markopesevski/medyp_1/20180103_proces_autocalibracio.txt

ÉS UN PROCÉS LLARG (~20 min), PACIÈNCIA.
proces per fer autocalibració:
0	connectar el provador a la sortida de RF que tingui connectat el relé més llunyà (Rele3, o connector CN10 a la placa)
1	entrar al menú secret
2	escriure un 0 a la temperatura d'alarma -> set
3	el led del switch hauria de començar a fer intermitències
4	llegir temperatura actual (botó READ)
5	hauria de començar el procés de warm-up durant 2 minuts donant RF a 3 MHz (nivell indeterminat, dependrà de cada placa)
6	després d'aquests 2 minuts de warm-up començarà a buscar els valors d'ajust fi i gruix per cada nivell de tensió donat
7	ESPERAR FINS QUE ACABI I NO TOCAR RES MÉS
8	quan l'aparell hagi apagat la RF (veure amb oscil·loscopi) voldrà dir que ja ha trobat tots els valors
9	donar al botó set de la temperatura d'alarma per sortir del mode de calibració
10	el led del switch hauria de deixar de fer intermitències
11	en aquest punt, sortir del menú secret i comprovar els valors donant RF des del menú normal
12	si els valors estan bé, tornar al menú secret i GUARDAR TODOS LOS VALORES
