markopesevski/medyp_1/20180208_transistors_petats.png

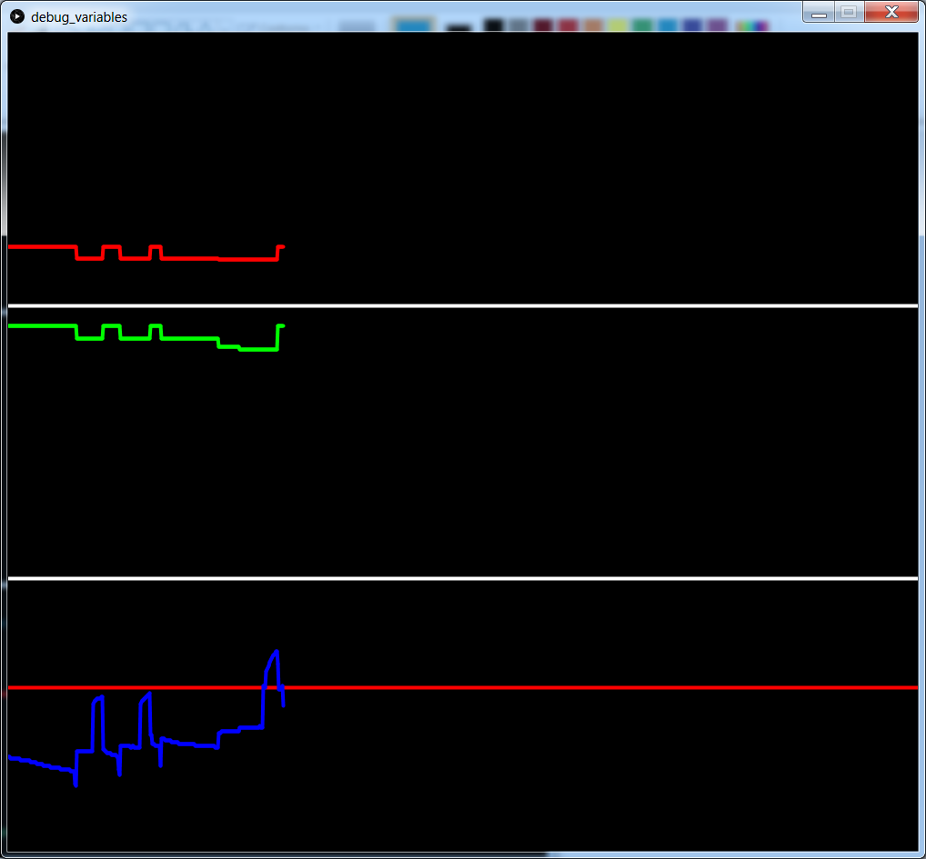
20180208_transistors_petats.png
