markopesevski/medyp_1/20180208_transistors_petats_explicat.png

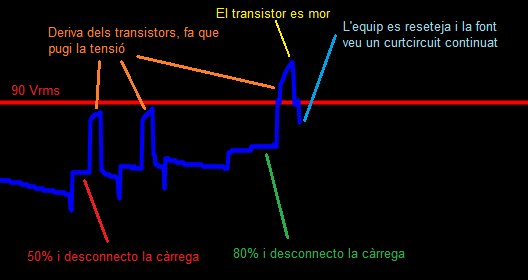
20180208_transistors_petats_explicat.png
