markopesevski/medyp_1/20180209_proves_amb_lluis_garcia.png

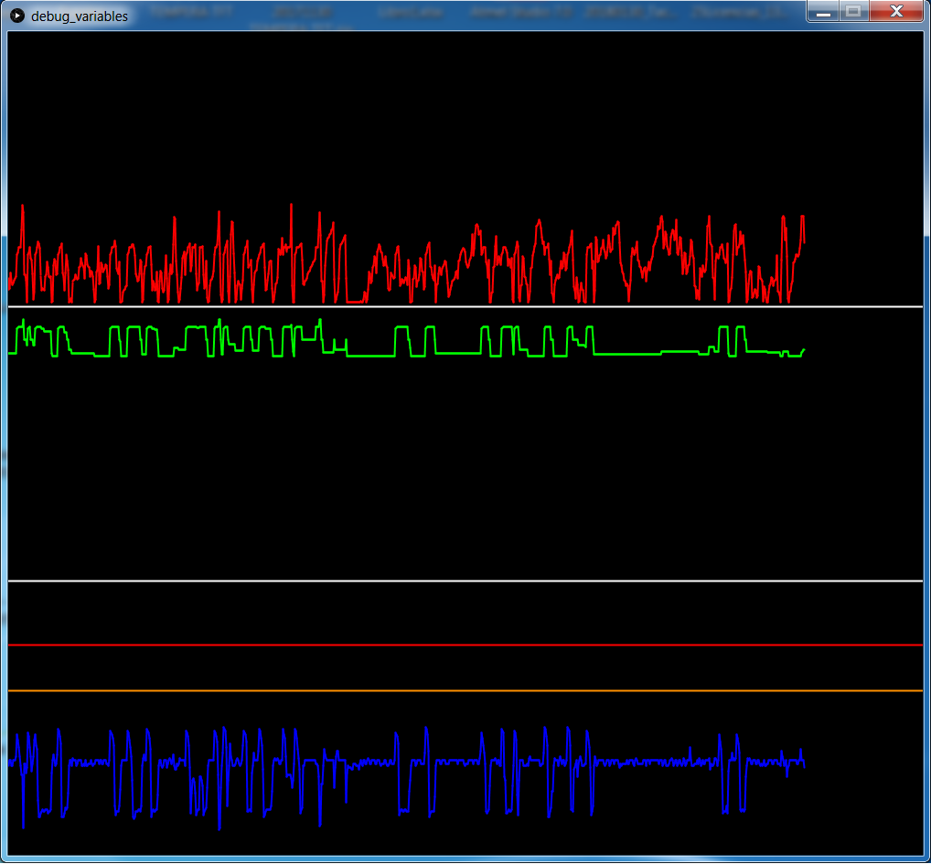
20180209_proves_amb_lluis_garcia.png
