markopesevski/medyp_1/docs/20171207_full control verificacio mesotreat rf_protos_3.xlsx

FULL CONTROL VERIFICACIÓ MESOTREAT
DATA |  | 2017-12-07 |  | Nº SERIE | 3
OPERARI |  | MP |  | VERSIÓ HDW | PROTO
VERSIÓ APK |  | 1 |  | VERSIÓ SFW | 0.1.2
ENCESA INT. OFF a ON |  |  | Ѵ |  | GALV. | 57
LED PULS. |  |  | Ѵ |  | STIM. | 110
PULSADOR |  |  | Ѵ |  | RF | 195
LED RUN |  |  | Ѵ |  | BIAS | 82
LED HUB |  |  | Ѵ |  | AL. TEMP. | 70
TOUCH INICI |  |  | Ѵ | TP9 | 24RF | PROTO Ѵ
STAND BY |  |  | Ѵ | TP13 | 12V | 12,12 Ѵ
APAGAT |  |  | Ѵ | TP11 | 5V IN TAB | 5,03 Ѵ
Fixació USB 1,2,3,4 |  |  | Ѵ | TP4 | 5V | PROTO Ѵ
Lectura Sensr.TEMP |  |  | Ѵ | TP10 | 3,3V | 3,29 Ѵ
 | 100% | 75% | 50% | 25% | 5% | 0%
1MHz -RF CORP. | 85.2 | 83.4 | 81.8 | 79.8 | 74.4 | Ѵ
1MHz -RF FACIAL | 84.9 | 82.9 | 76.8 | 59.8 | 43.3 | Ѵ
1MHz -RF ESPEC. | 84.9 | 82.9 | 76.8 | 59.8 | 43.3 | Ѵ
3MHz -RF CORP. | 75.3 | 69.4 | 62.8 | 53.4 | 41.8 | Ѵ
3MHz -RF FACIAL | 81.1 | 68.4 | 53.8 | 35.8 | 24.7 | Ѵ
3MHz -RF ESPEC. | 81.1 | 68.4 | 53.8 | 35.8 | 24.7 | Ѵ
1-3MHz -RF CORP.CN1 | Ѵ
1-3MHz -RF FACIAL.CN2 | Ѵ
1-3MHz -RF ESPEC.CN3 | Ѵ
G. DETECTA PROBE | Ѵ
GALV.-RF CORP.CN1 | 1.537 | 1.154 | 0.77 | 0.387 | 0.095 | Ѵ
GALV.-RF FACIAL.CN2 | Ѵ
GALV.-RF ESPEC.CN3 | Ѵ
LIFTING GALV. | N/A | N/A | N/A | N/A | N/A | N/A
LIFTING | 61.6 | 47.2 | 30.8 | 14.4 | 1.84 | Ѵ
STIM A CIRCULAT. | 84 | 68.8 | 48 | 24 | 4.8 | Ѵ
STIM B CIRCULAT. | 80 | 70.4 | 48.8 | 24.8 | 4.8 | Ѵ
Senyal DRENANT. | Ѵ
Senyal TENS | Ѵ
Senyal PERCUS. | Ѵ
Senyal REAFIRM. | Ѵ
Senyal PERMEAB. | Ѵ
 |  |  |  | Ѵ | PASS
 |  |  |  |  | FAULT
 |  |  |  | Ѵ | PASS
