markopesevski/medyp_1/20180116_comparativa_autocalibracio_lent_vs_rapid.xlsx

 |  | rapid
 |  | 1 MHz facial |  | 1 MHz corporal |  | 1 MHz especific |  | 3 MHz facial |  | 3 MHz corporal |  | 3 MHz especific |  | barrido facial |  | barrido corporal |  | barrido especific
Index | % | LEVEL | DACDDS | LEVEL | DACDDS | LEVEL | DACDDS | LEVEL | DACDDS | LEVEL | DACDDS | LEVEL | DACDDS | LEVEL | DACDDS | LEVEL | DACDDS | LEVEL | DACDDS
0 | 0.0 | 255 | 255 | 255 | 255 | 255 | 255 | 255 | 255 | 255 | 255 | 255 | 255 | 255 | 255 | 255 | 255 | 255 | 255
1 | 5.0 | 231 | 50 | 219 | 43 | 231 | 50 | 236 | 49 | 231 | 43 | 236 | 49 | 233 | 49 | 225 | 43 | 233 | 49
2 | 10.0 | 230 | 43 | 219 | 43 | 230 | 43 | 234 | 54 | 227 | 43 | 235 | 48 | 232 | 48 | 223 | 43 | 232 | 45
3 | 15.0 | 228 | 45 | 219 | 43 | 228 | 45 | 234 | 48 | 223 | 43 | 233 | 53 | 231 | 46 | 221 | 43 | 230 | 49
4 | 20.0 | 226 | 48 | 219 | 43 | 226 | 49 | 226 | 117 | 220 | 43 | 225 | 127 | 226 | 82 | 219 | 43 | 225 | 88
5 | 25.0 | 224 | 52 | 218 | 43 | 225 | 43 | 233 | 44 | 217 | 43 | 232 | 43 | 228 | 48 | 217 | 43 | 228 | 43
6 | 30.0 | 223 | 46 | 217 | 43 | 224 | 47 | 231 | 43 | 215 | 44 | 231 | 46 | 227 | 44 | 216 | 43 | 227 | 46
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
