markopesevski/medyp_1/docs/20171207_CONTROL_VERIFICACION_MESOTREAT_RF_3.xlsx

CONTROL VERIFICACIÓ MESOTREAT RF
DATA: | 07/12/2017 |  |  |  |  | VERSIÓ APK: |  |  |  | 1
EQUIP Nº | PROTO 003 |  | PCB Nº S/N |  | 3 | VERSIÓ PLACA: |  |  |  | 0,1,2
 | 100% (Vpp-rms) |  |  | 75% (Vpp-rms) |  |  | 50% (Vpp-rms) |  |  | 25% (Vpp-rms) |  |  | 5% (Vpp-rms) |  |  | 0% és 0?
 | Min | Mesura | Max | Min | Mesura | Max | Min | Mesura | Max | Min | Mesura | Max | Min | Mesura | Max
RF CORPORAL 1Mhz | 85,1 |  | 85,6 | 83,5 |  | 84 | 83 |  | 83,4 | 79 |  | 80
RF FACIAL 1Mhz | 84,8 |  | 85,2 | 82,9 |  | 83,2 | 77 |  | 77,5 | 62,1 |  | 63
RF CONTORNO 1Mhz | 84,8 |  | 85,2 | 82,9 |  | 83,2 | 77 |  | 77,5 | 62,1 |  | 63
RF CORPORAL 3Mhz | 76,1 |  | 77,3 | 70,6 |  | 71,2 | 63,8 |  | 64,3 | 54 |  | 55,4
RF FACIAL 3Mhz | 74,8 |  | 75,2 | 67,8 |  | 68,3 | 52,8 |  | 54,2 | 34,5 |  | 35,2
RF CONTORNO 3Mhz | 74,8 |  | 75,2 | 67,8 |  | 68,3 | 52,8 |  | 54,2 | 34,5 |  | 35,2
RF CORPORAL 1Mhz - 3Mhz
RF FACIAL 1Mhz - 3Mhz
RF CONTORNO 1Mhz - 3Mhz
 | 100% (mA) |  |  | 75% (mA) |  |  | 50% (mA) |  |  | 25% (mA) |  |  | 5% (mA)
 | Min | Mesura | Max | Min | Mesura | Max | Min | Mesura | Max | Min | Mesura | Max | Min | Mesura | Max
GALVA. CORPORAL
GALVA. FACIAL
GALVA.CONTORNO
 | 100% (Vpp) |  |  | 75% (Vpp) |  |  | 50% (Vpp) |  |  | 25% (Vpp) |  |  | 5% (Vpp)
 | Min | Mesura | Max | Min | Mesura | Max | Min | Mesura | Max | Min | Mesura | Max | Min | Mesura | Max
ELECTROLIFTING
 | 100% (Vp) |  |  | 75% (Vp) |  |  | 50% (Vp) |  |  | 25% (Vp) |  |  | 5% (Vp)
 | Min | Mesura | Max | Min | Mesura | Max | Min | Mesura | Max | Min | Mesura | Max | Min | Mesura | Max
ESTIM A CIRCULATORIA
ESTIM A DRENANTE
ESTIM A TENS
ESTIM A PERCUSION
ESTIM A REAFIRMANTE
ESTIM A PERMEABILIZANTE
ESTIM A CIRCULATORIA
ESTIM A DRENANTE
ESTIM A TENS
ESTIM A PERCUSION
ESTIM A REAFIRMANTE
ESTIM A PERMEABILIZANTE
 |  |  |  | VALORS DAC
ENCESA | OK |  |  | GALVA
CARREGA SOFT APP | OK |  |  | ESTIM
CARREGA SOFT PCB |  |  |  | RF
 |  |  |  | BIAS
 |  |  |  | ALARMA Tº
