markopesevski/medyp_1/sch/mesotreat.pdf

A

B

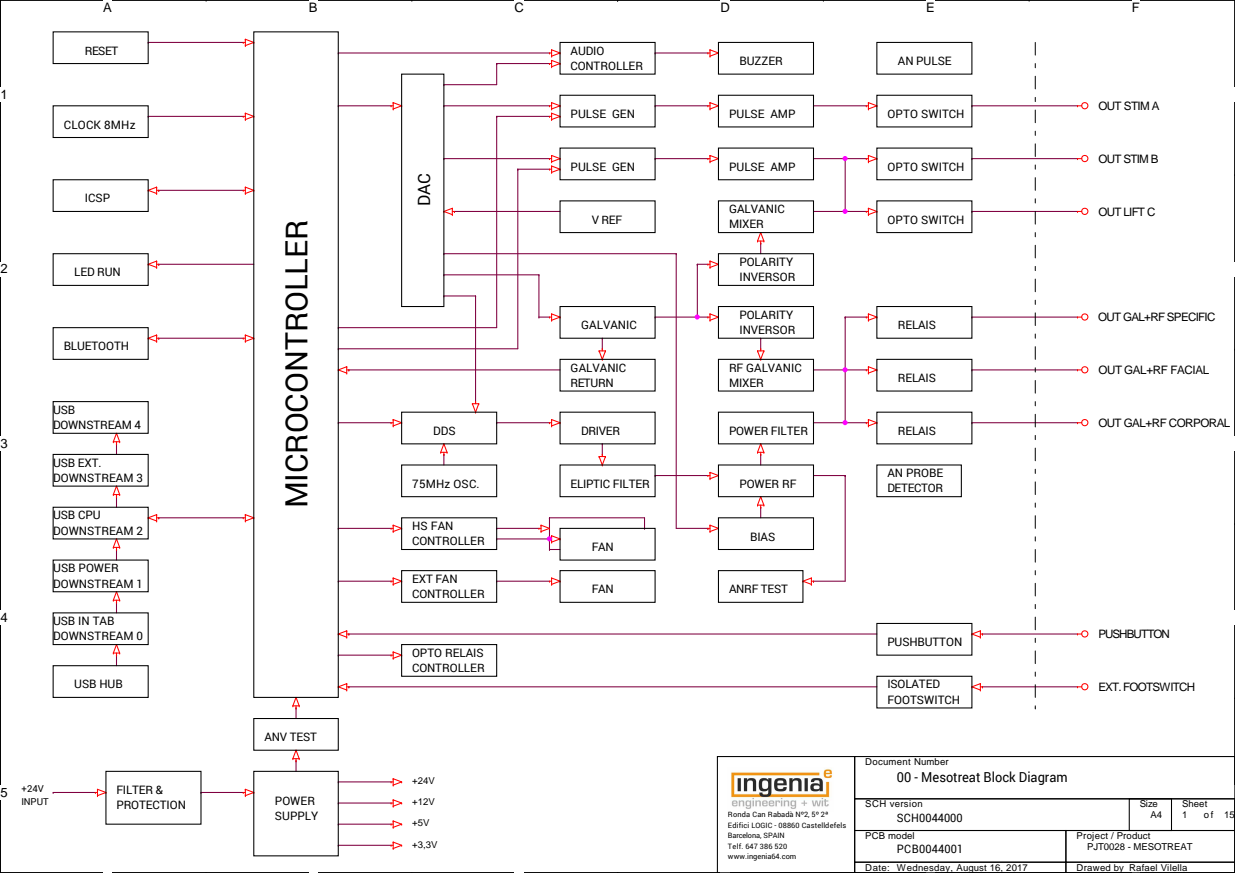
[picture p4: page 1]
EXT. FOOTSWITCH; OUT STIM A; OUT STIM B; OUT LIFT C; PUSHBUTTON; SCH version; Size; Date:; Drawed by; Sheet o f; PCB model; Project / Product; SCH0044000; PCB0044001; Wednesday, August 16, 2017; Rafael Vilella; PJT0028 - MESOTREAT; MICROCONTROLLER; DAC; CLOCK 8MHz; ISOLATED FOOTSWITCH; ICSP; LED RUN; USB HUB; RESET; FILTER & PROTECTION; INPUT; POWER; SUPPLY; DDS; DRIVER; POWER FILTER; GALVANIC RETURN; RELAIS; RF GALVANIC MIXER; POLARITY INVERSOR GALVANIC; POLARITY INVERSOR; OPTO SWITCH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

OUT GAL+RF SPECIFIC

OUT GAL+RF FACIAL

OUT GAL+RF CORPORAL

USB IN TAB
DOWNSTREAM 0

Document Number
00 - Mesotreat Block Diagram

Ronda Can Rabadà Nº2, 5º 2ª
Edifici LOGIC - 08860 Castelldefels
Barcelona, SPAIN
Telf. 647 386 520
www.ingenia64.com

A

B

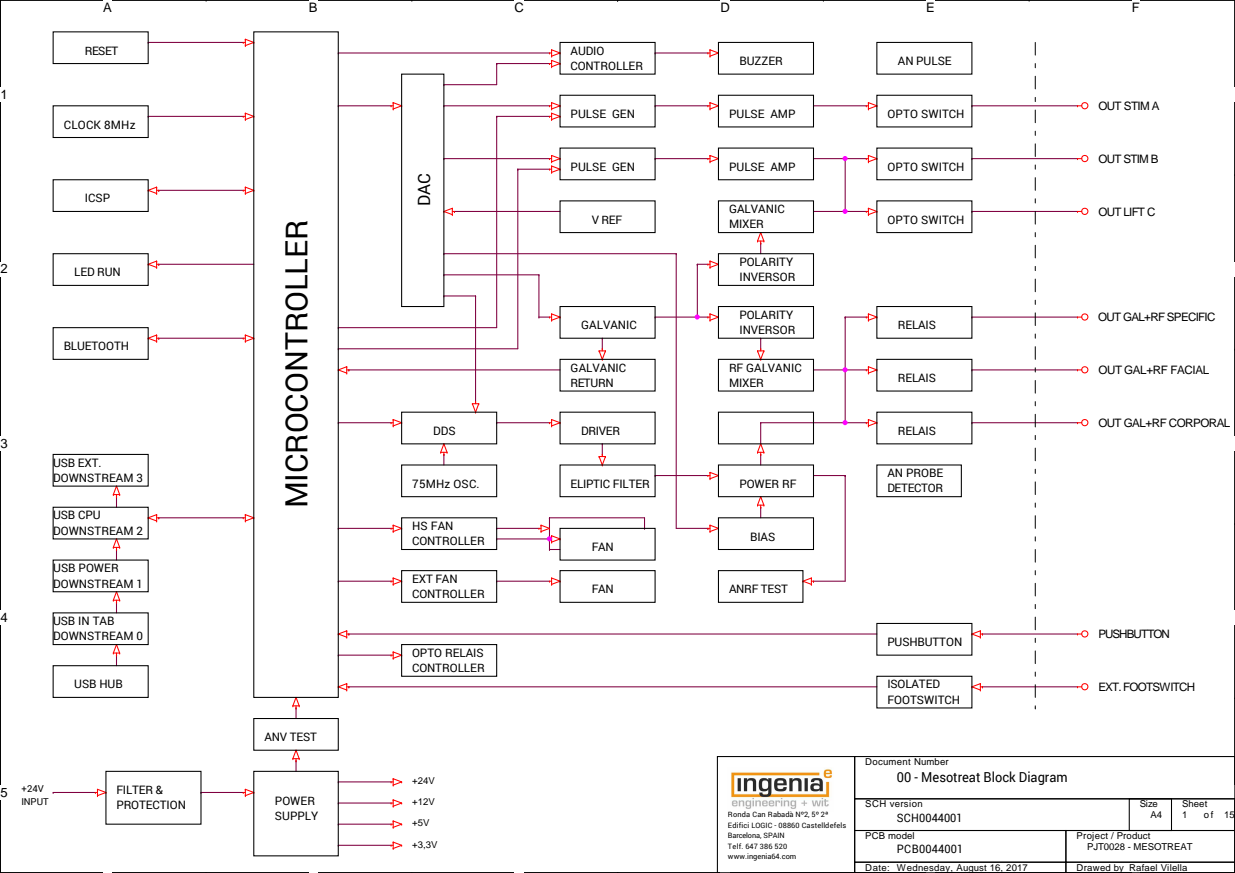
[picture p5: page 2]
EXT. FOOTSWITCH; OUT STIM A; OUT STIM B; OUT LIFT C; PUSHBUTTON; SCH0044001; MICROCONTROLLER; DAC; CLOCK 8MHz; ISOLATED FOOTSWITCH; ICSP; LED RUN; USB HUB; RESET; FILTER & PROTECTION; INPUT; POWER; SUPPLY; DDS; DRIVER; GALVANIC RETURN; RELAIS; RF GALVANIC MIXER; POLARITY INVERSOR GALVANIC; POLARITY INVERSOR; OPTO SWITCH; PULSE AMP; GALVANIC MIXER V REF; 75MHz OSC.; ELIPTIC FILTER; POWER RF; PULSE GEN; BLUETOOTH; BUZZER; AUDIO CONTROLLER; USB EXT. DOWNSTREAM 3; USB CPU DOWNSTREAM 2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

OUT GAL+RF SPECIFIC

OUT GAL+RF FACIAL

OUT GAL+RF CORPORAL

USB IN TAB
DOWNSTREAM 0

Document Number
00 - Mesotreat Block Diagram

D | D
C | C
B | B
A | A

Document Number

### 01 - Miscellanea

A4 | 1 | 15

TORNILLERIA RADIADORS TIP120 SCH 04

PCB0044000 4 LAYERS

TORNILLERIA RADIADOR
7812 SCH 09

TORNILLERIA RADIADOR IRF640x2 LM2596 QFP17P10 LM35 SCH 2 i SCH 10

TORNILLERIA i VENTILADOR

SCWx = SCREW

APx = ARANDELA PLANA

ADIx = ARANDELA DENTADA INTERIOR

NUTx = FAMELLA

ISOx = CLIP PADA 7705

HSPx = HEATSINK PAD

ISO2
M3

SCW6
M3x10

SCW10
M-3,5x35

HSP4
M3

PCB1

PCB0044000

ISO1
M3

FAN1
40x40x20-24V

ISO3
M3

SCW8
M3x10

HSP3
M3

ISO15
M3

NUT5
M3

AP5
M3

ADI5
M3

HSP5
M3

HSP1
M3

SCW5
M3x10

SCW9
M3x10

SCW7
M3x10

HSP2
M3

ISO4
M3

D | D

### Iout=??ADC

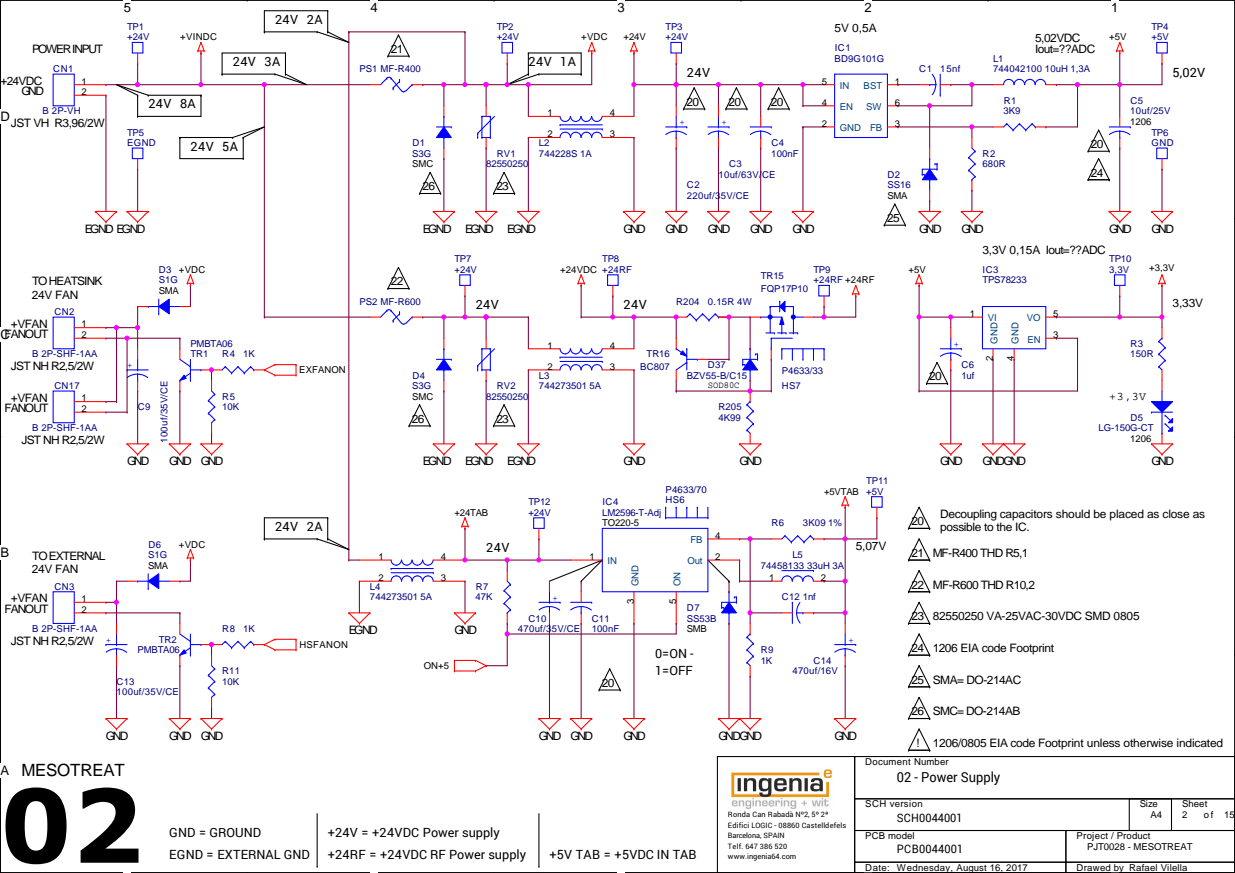
[picture p6: page 4]

Decoupling capacitors should be placed as close as
possible to the IC. 20

! 1206/0805 EIA code Footprint unless otherwise indicated

D | D

### GND

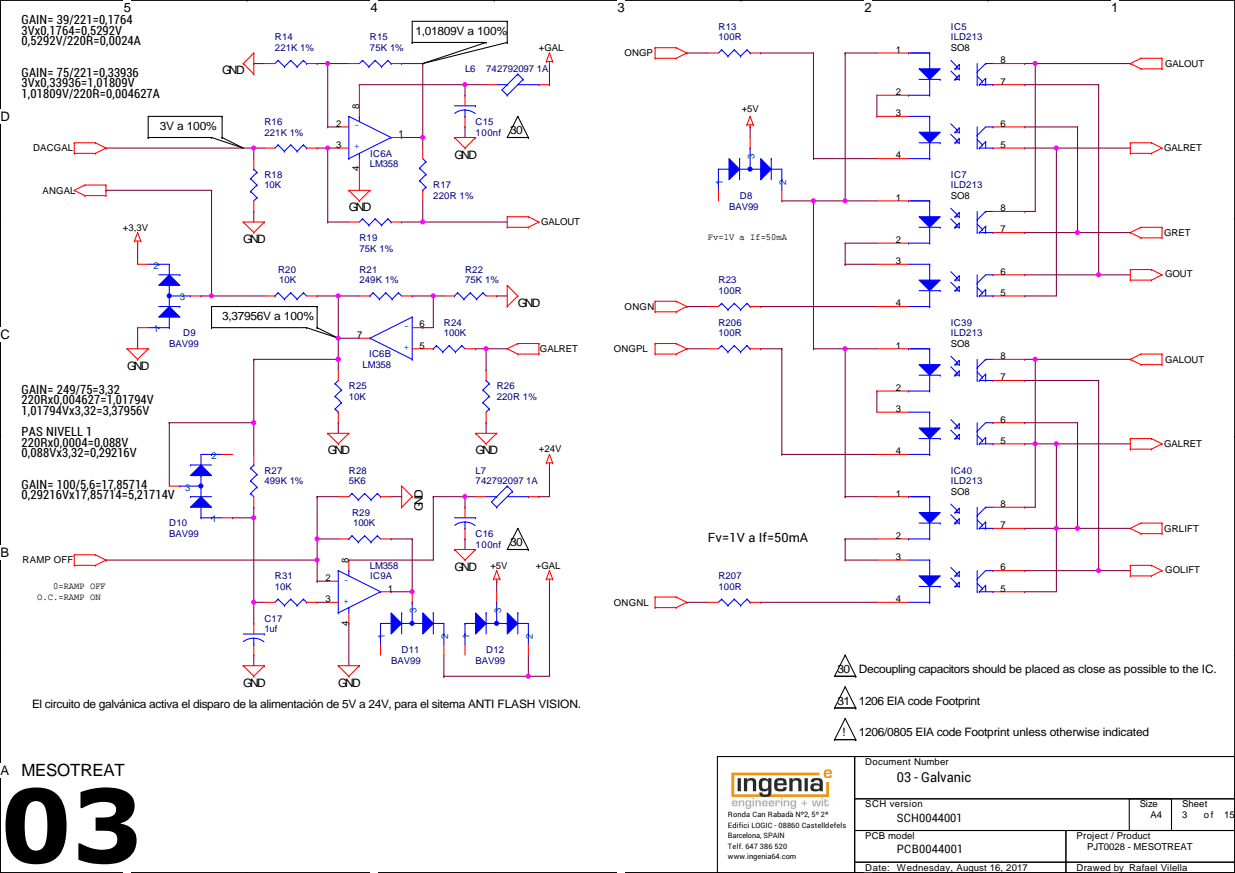
[picture p7: page 5]

30 Decoupling capacitors should be placed as close as possible to the IC.

El circuito de galvánica activa el disparo de la alimentación de 5V a 24V, para el sitema ANTI FLASH VISION.

! 1206/0805 EIA code Footprint unless otherwise indicated

D | D

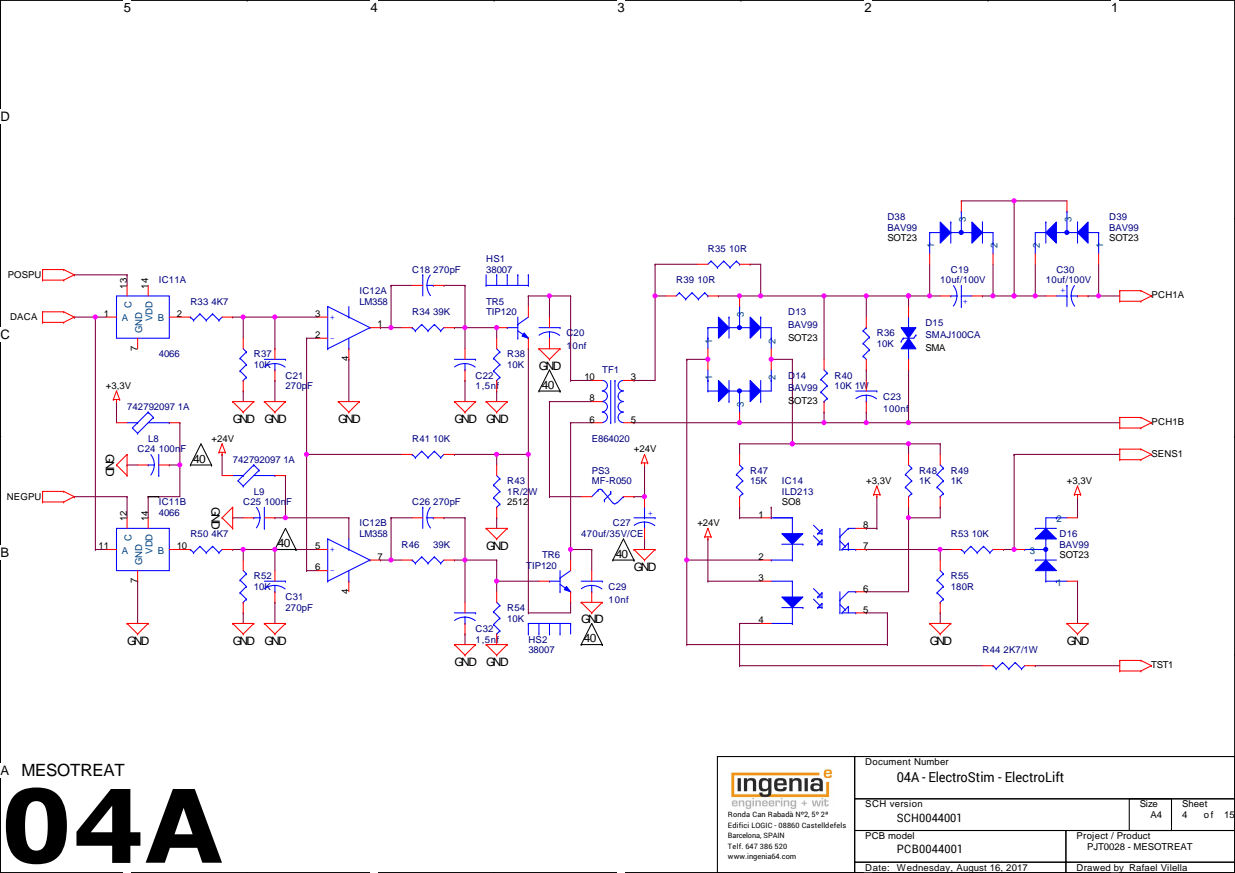
[picture p8: page 6]

D | D

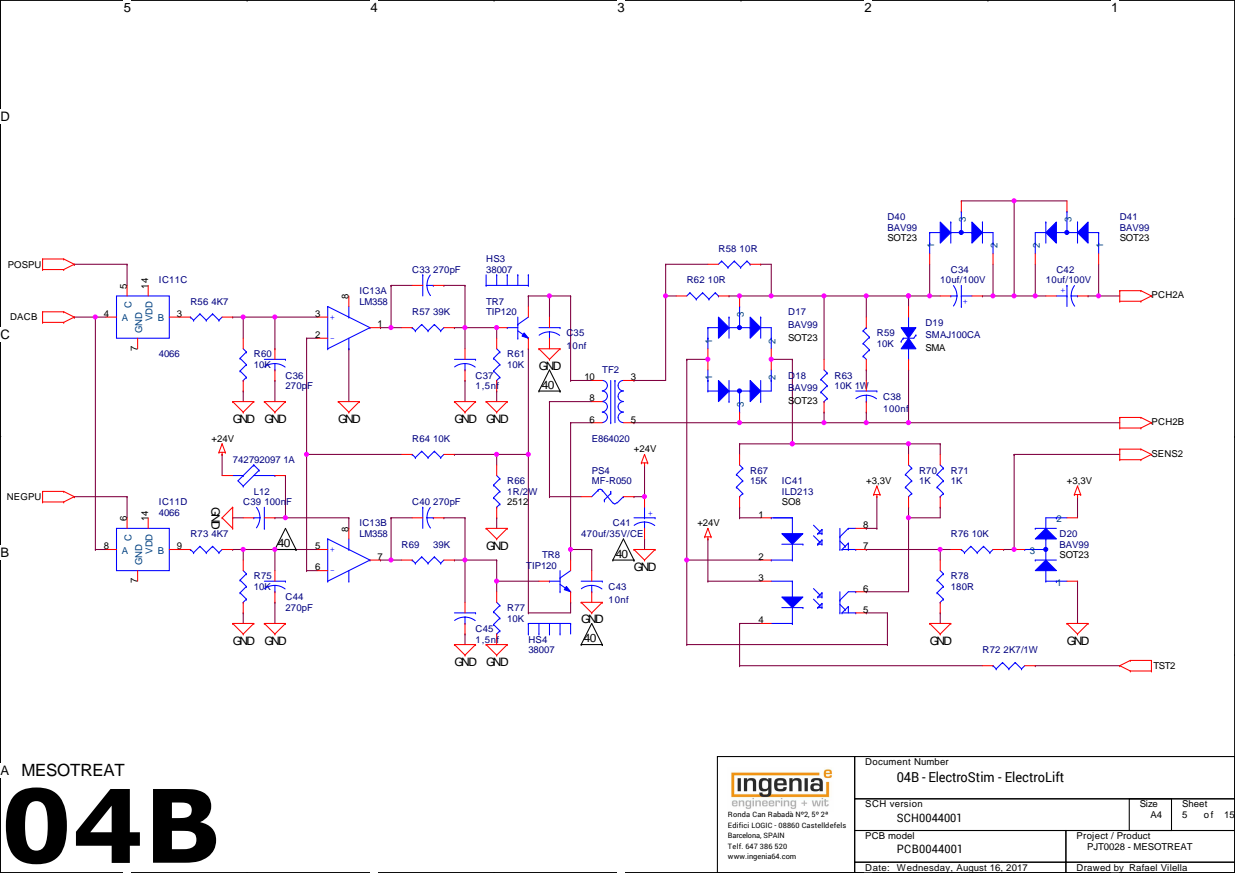
[picture p9: page 7]

D | D
GND | GND

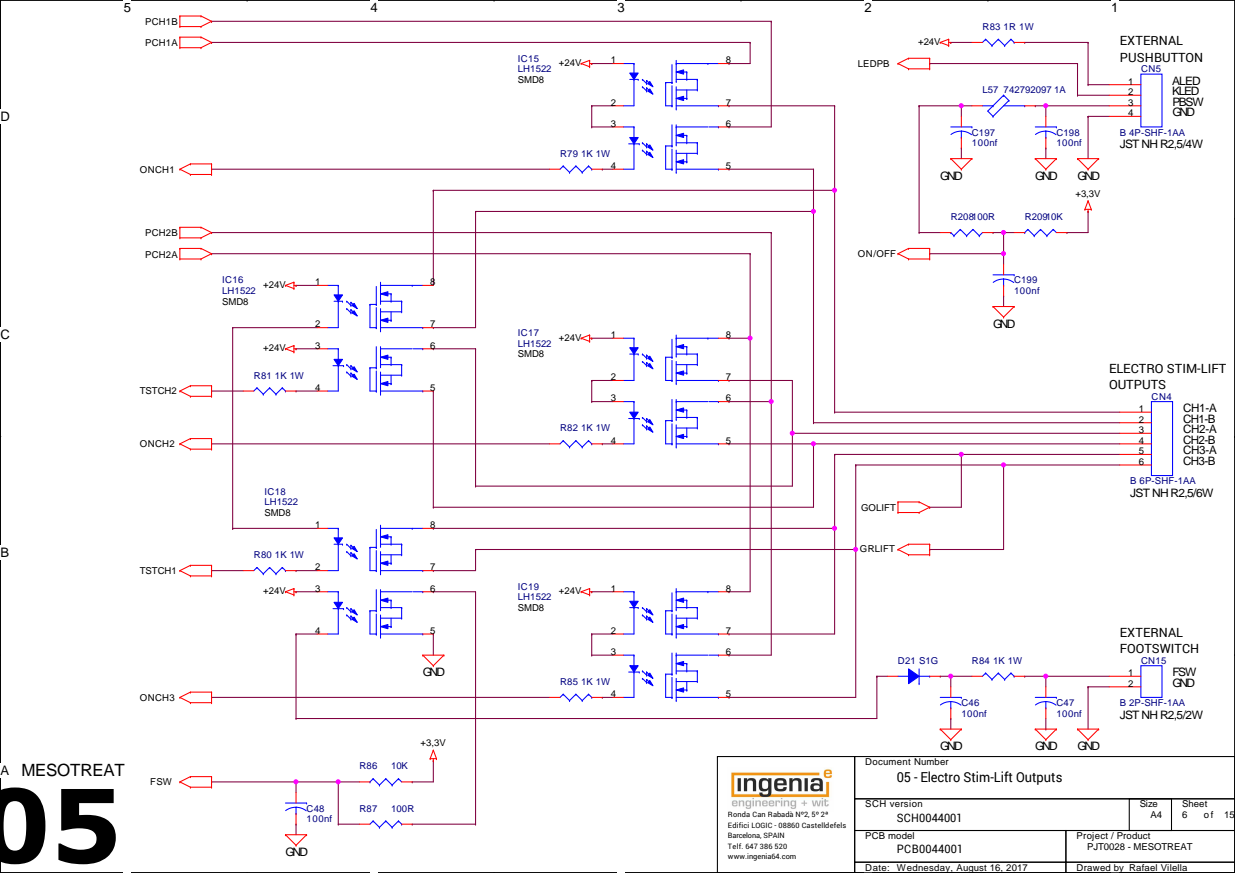
[picture p10: page 8]

Document Number
05 - Electro Stim-Lift Outputs

D | D

61

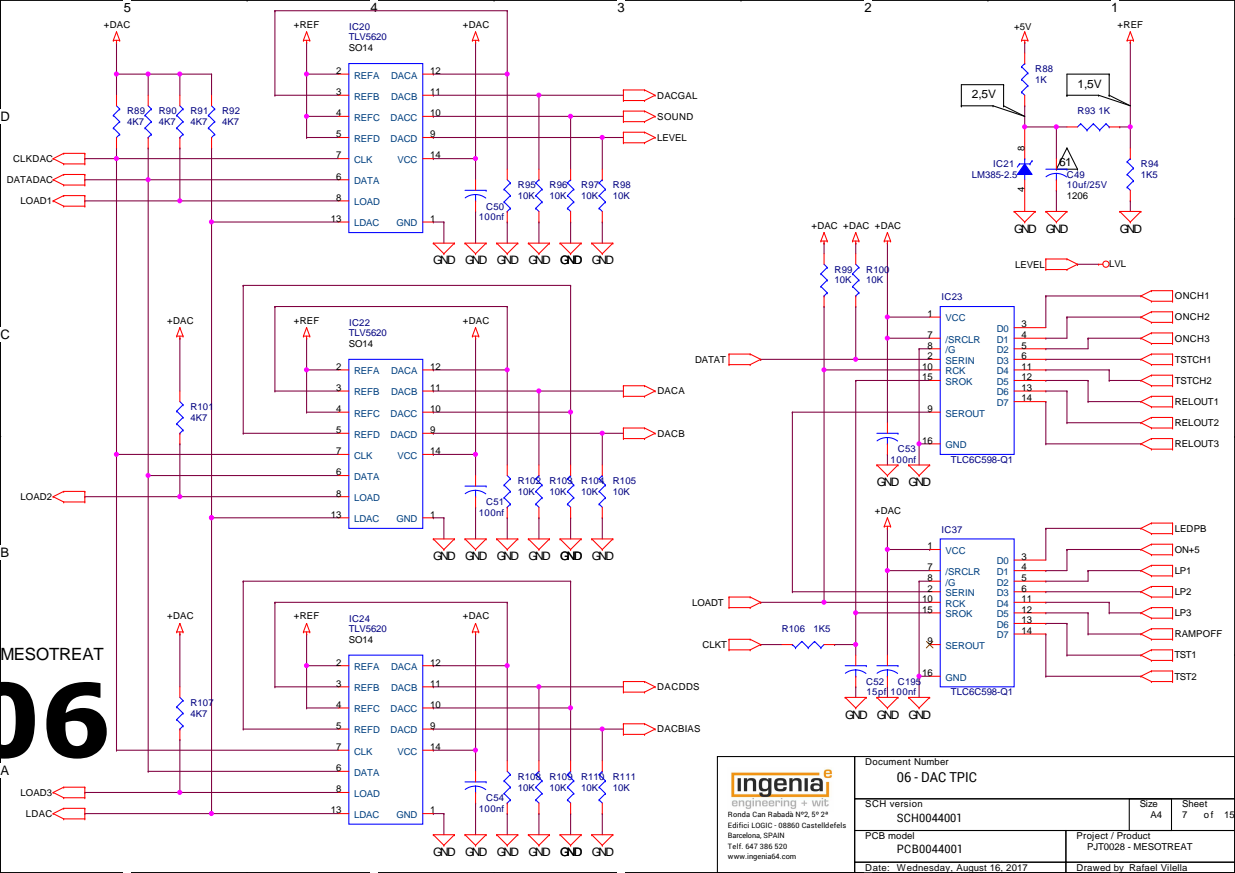
[picture p11: page 9]

D | D

### GND

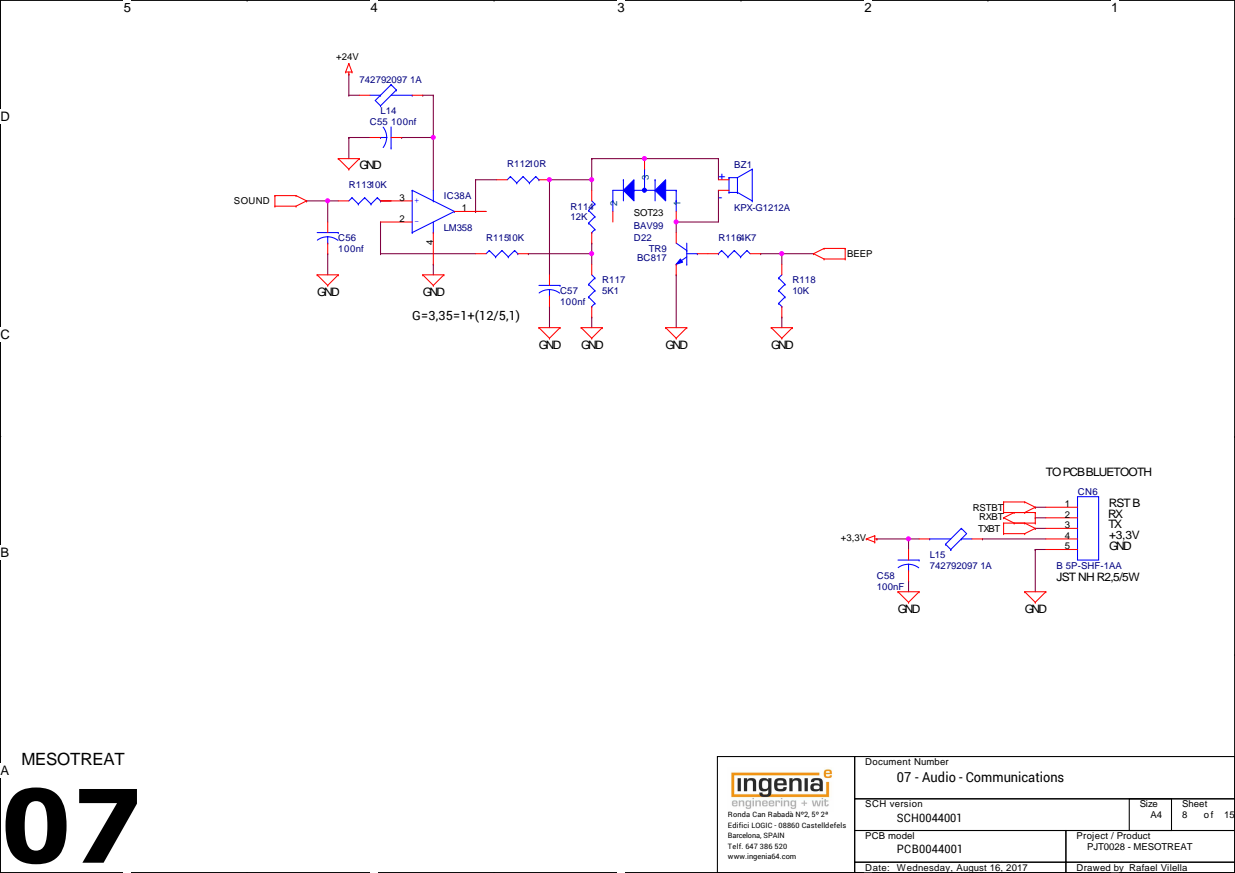
[picture p12: page 10]

D | D

### GND

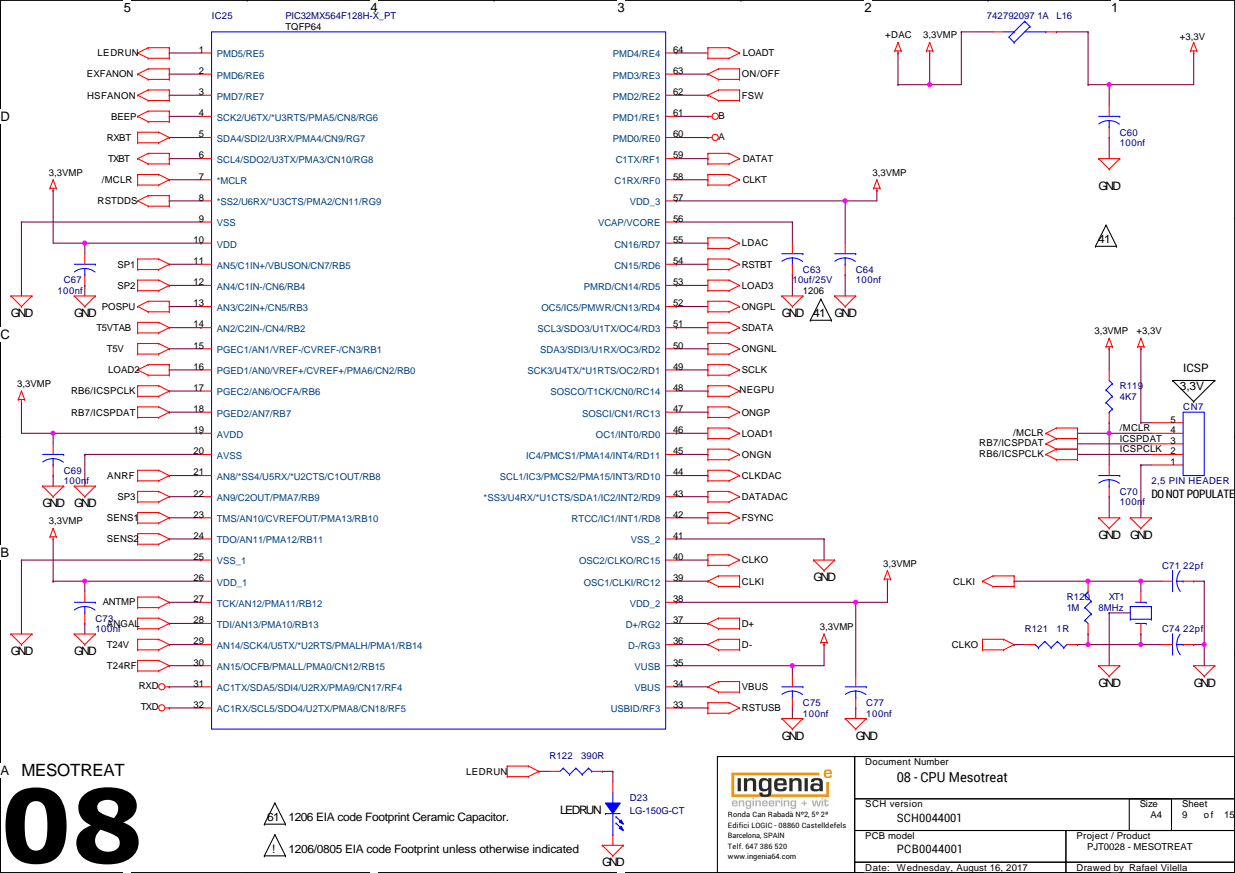
[picture p13: page 11]

61 1206 EIA code Footprint Ceramic Capacitor.

! 1206/0805 EIA code Footprint unless otherwise indicated

D | D
GND | GND

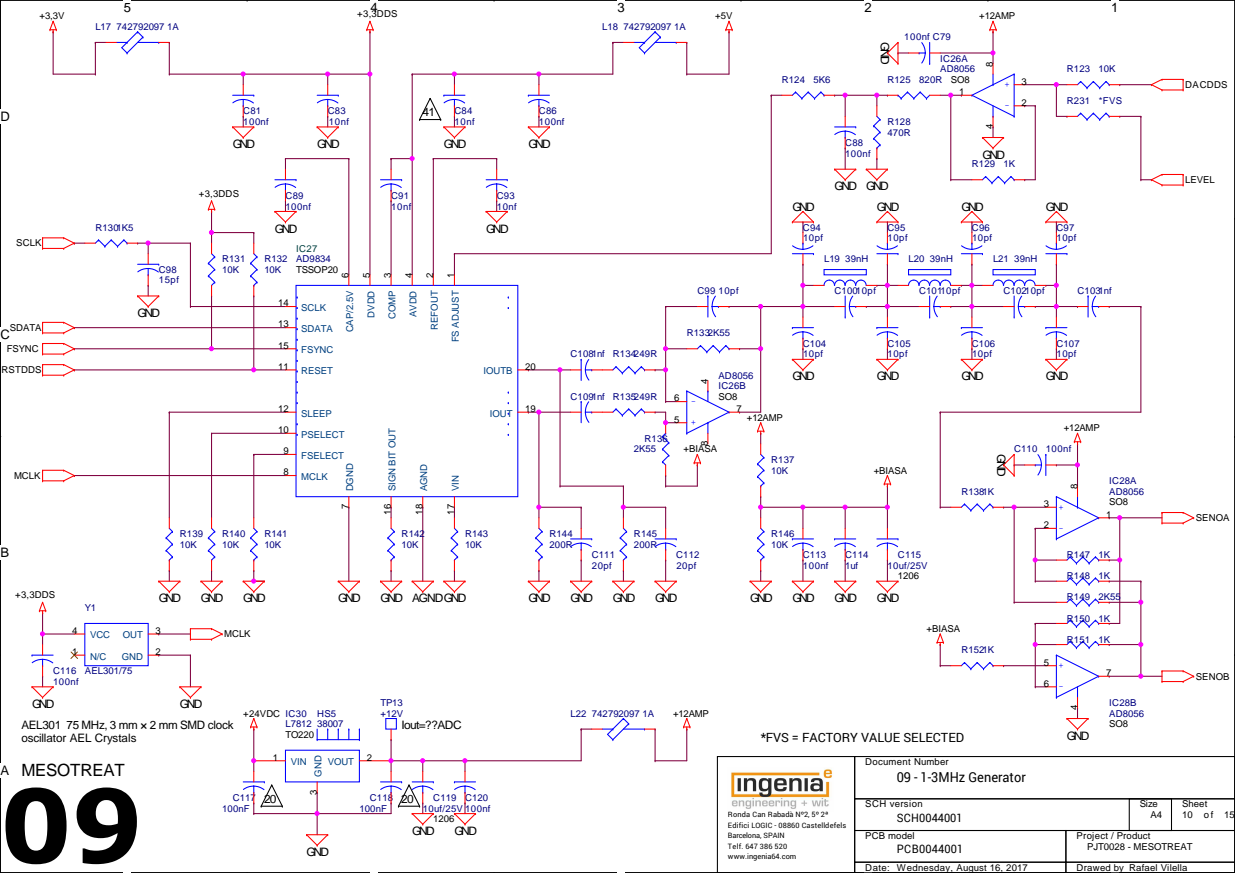
[picture p14: page 12]

*FVS = FACTORY VALUE SELECTED

D

D

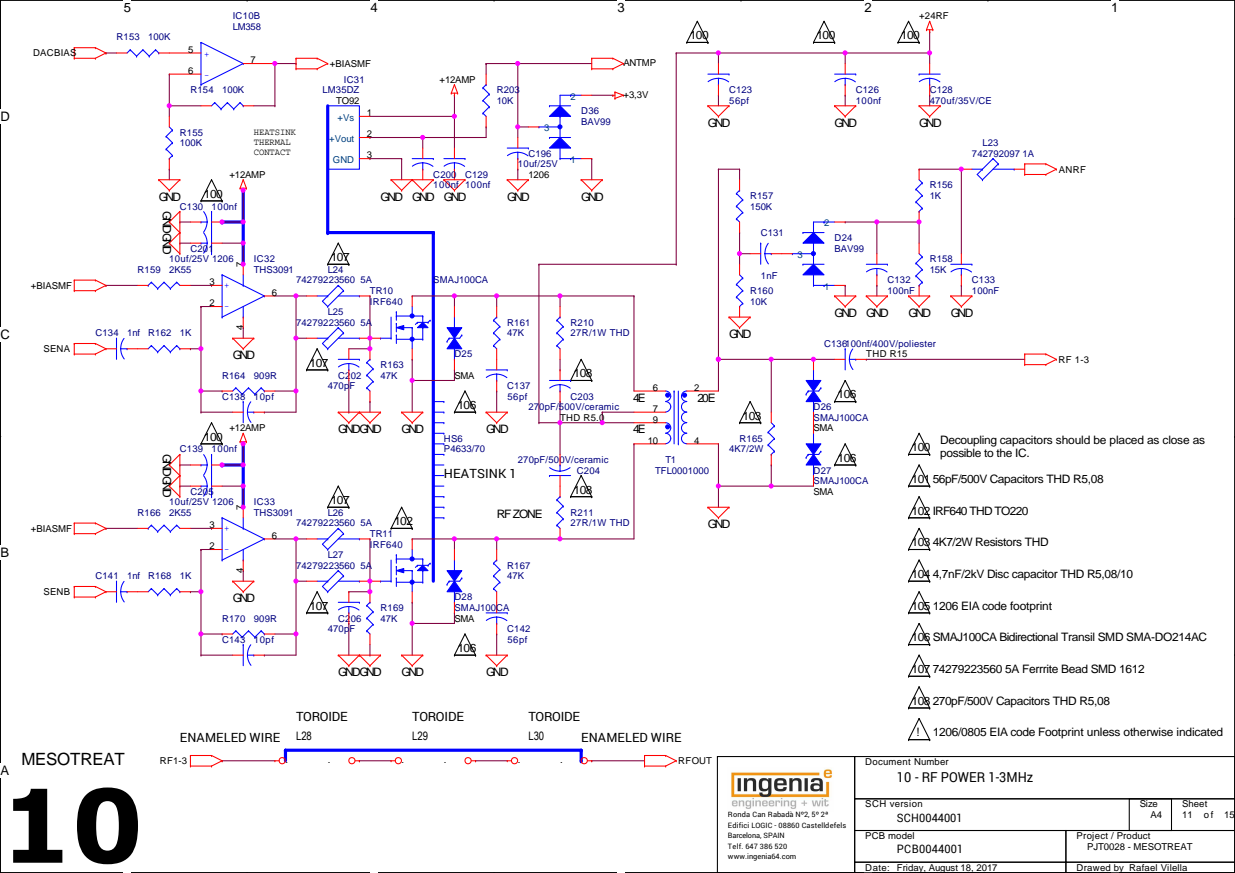
[picture p15: page 13]

Decoupling capacitors should be placed as close as
possible to the IC. 100

106 SMAJ100CA Bidirectional Transil SMD SMA-DO214AC

! 1206/0805 EIA code Footprint unless otherwise indicated

D | D

### SENSE PROBE

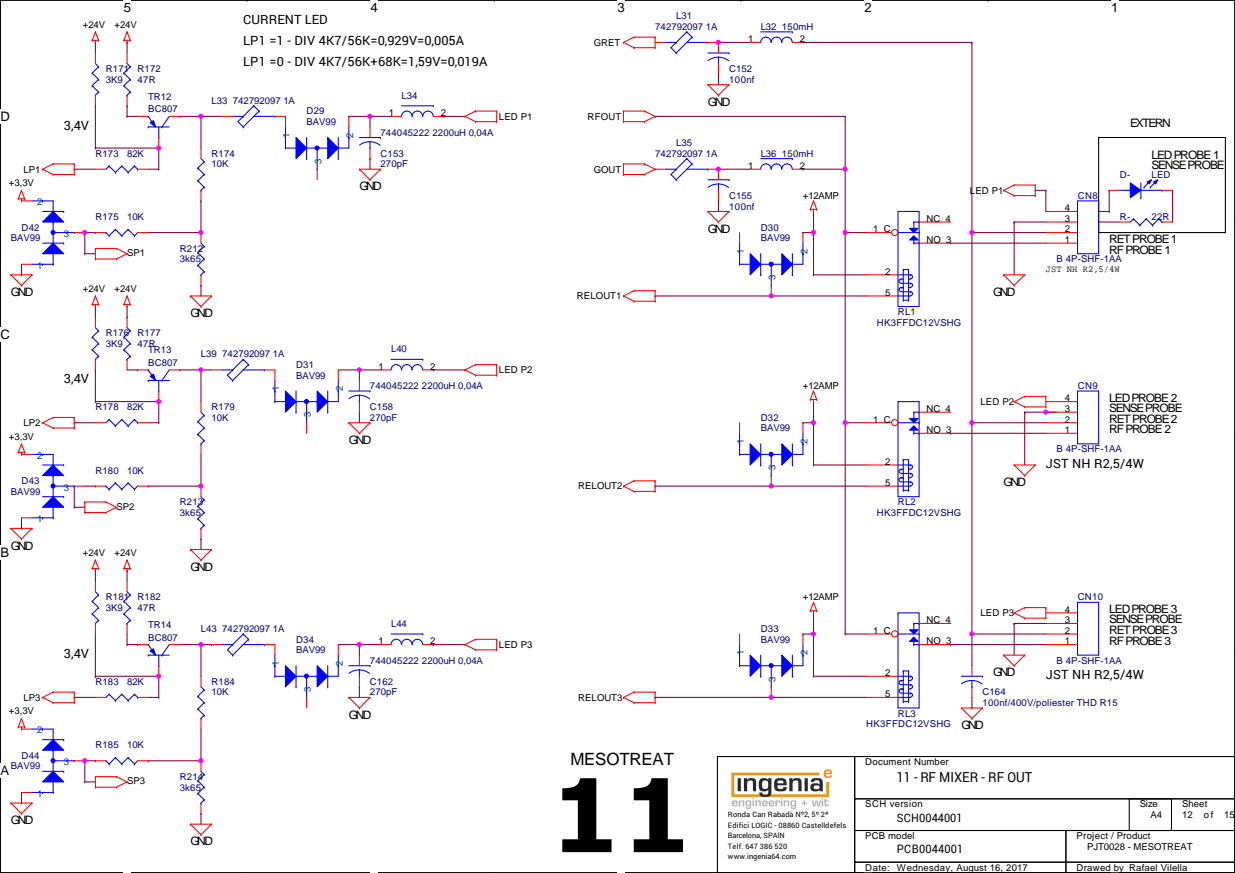
[picture p16: page 14]

Document Number
11 - RF MIXER - RF OUT

A | A

### GND

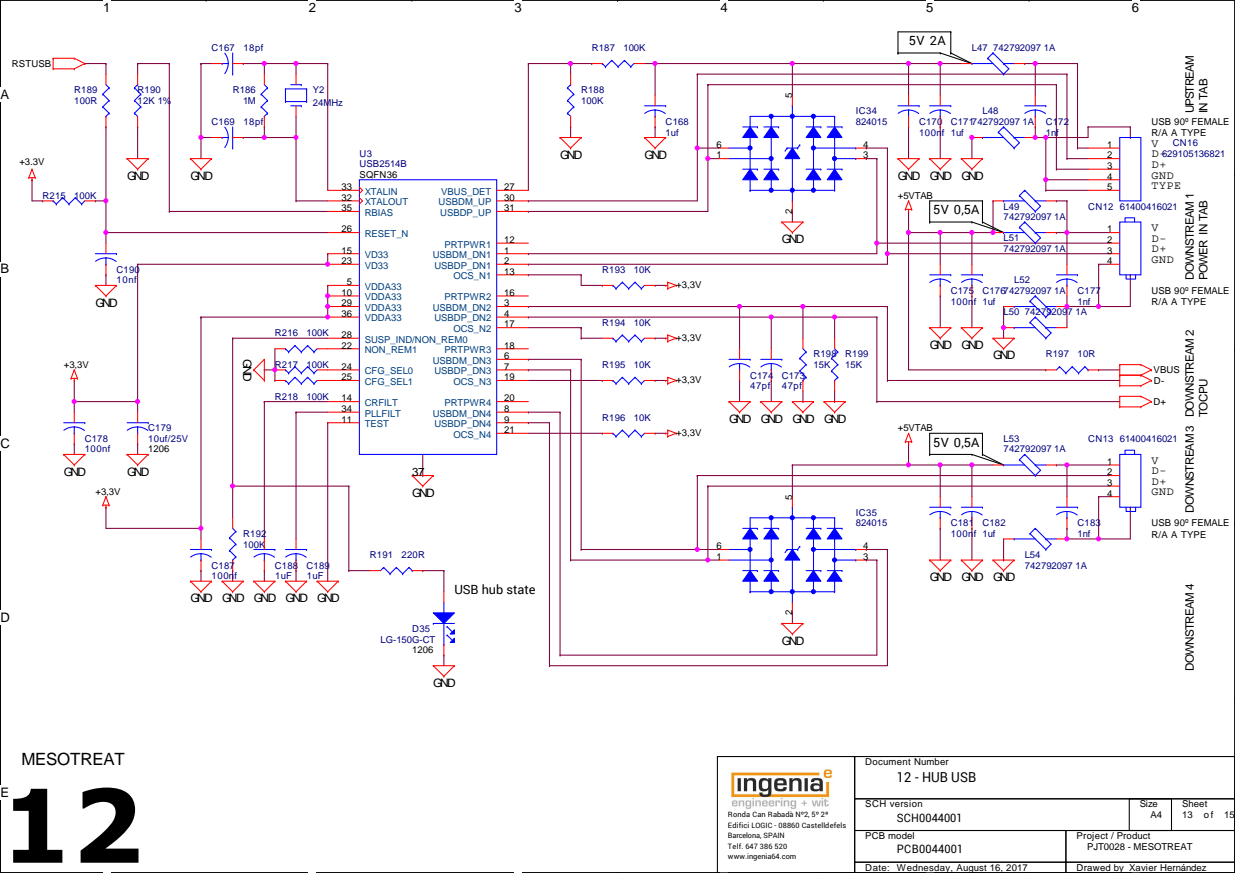
[picture p17: page 15]

GND | | 4

GND GND

D | D

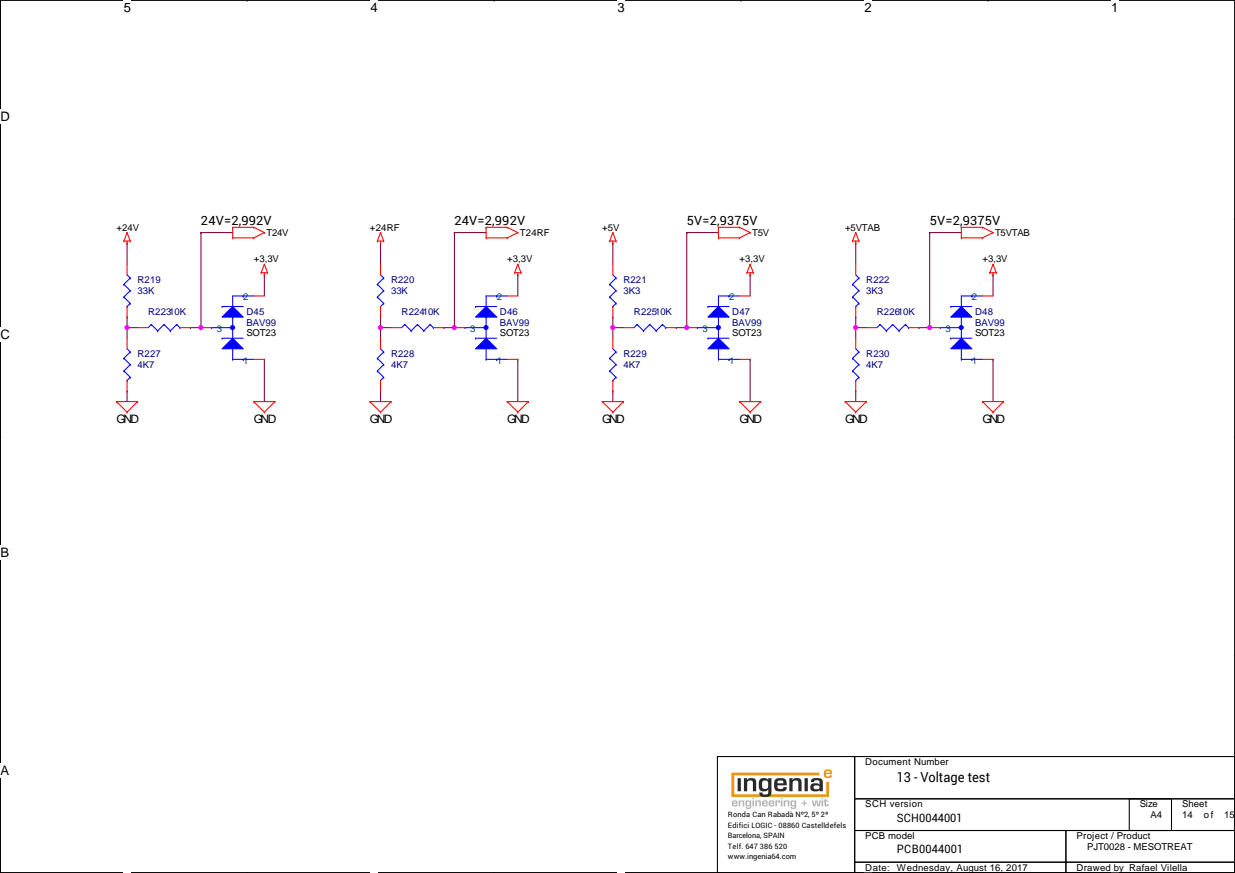
[picture p18: page 16]

D | D

### PROBE RESISTOR VALUE

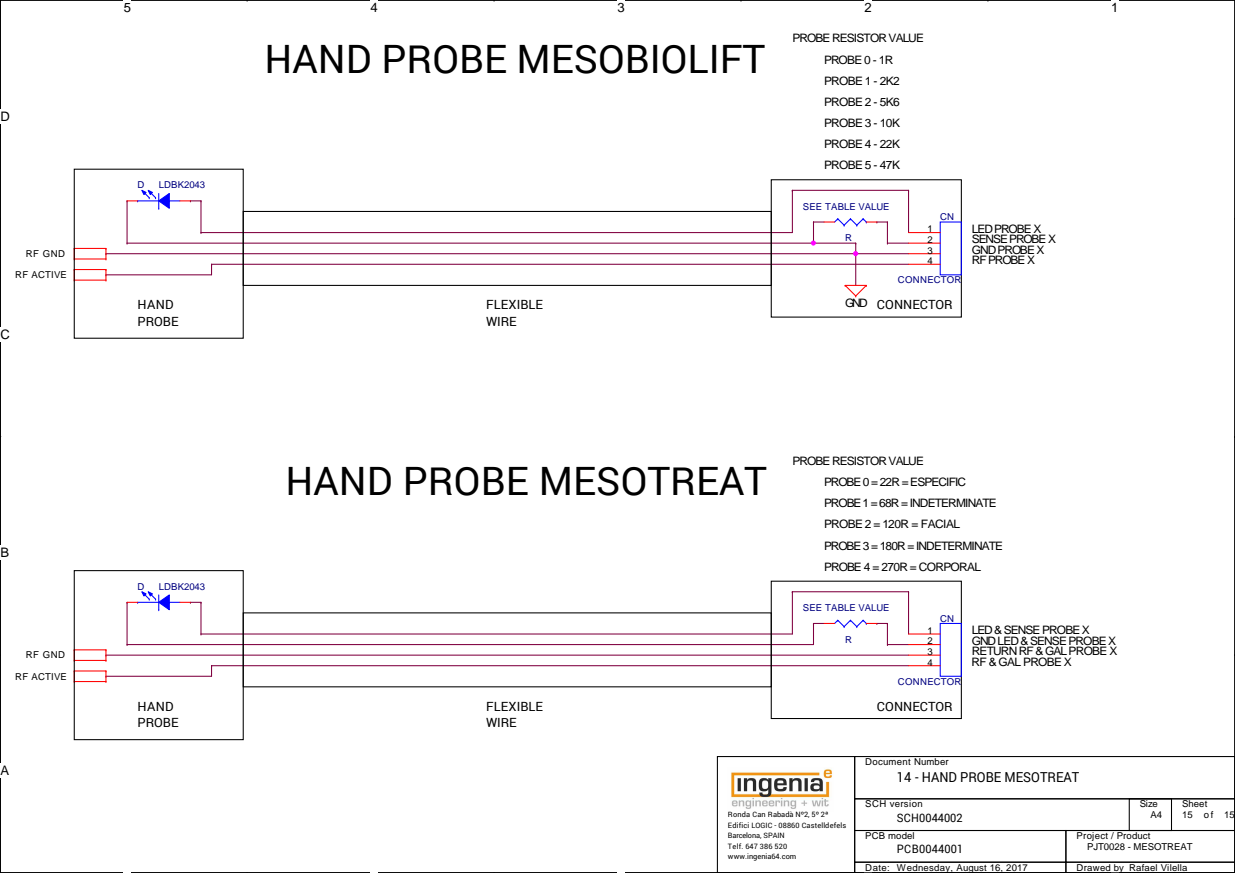
[picture p19: page 17]
RF GND; RF ACTIVE; SCH0044002; SENSE PROBE X; RF PROBE X; GND PROBE X; LED PROBE X; FLEXIBLE; CONNECTOR; WIRE; HAND PROBE; PROBE 0 - 1R; PROBE 1 - 2K2; PROBE 2 - 5K6; PROBE 3 - 10K; PROBE 4 - 22K; PROBE 5 - 47K; GND; LDBK2043

HAND PROBE MESOBIOLIFT

SEE TABLE VALUE

PROBE RESISTOR VALUE
PROBE 0 = 22R = ESPECIFIC
PROBE 1 = 68R = INDETERMINATE
PROBE 2 = 120R = FACIAL
PROBE 3 = 180R = INDETERMINATE
PROBE 4 = 270R = CORPORAL

HAND PROBE MESOTREAT

LED & SENSE PROBE X
GND LED & SENSE PROBE X
RETURN RF & GAL PROBE X
RF & GAL PROBE X

Document Number
14 - HAND PROBE MESOTREAT
