markopesevski/medyp_1/sch/PCB0044001 Serigrafia comp.pdf

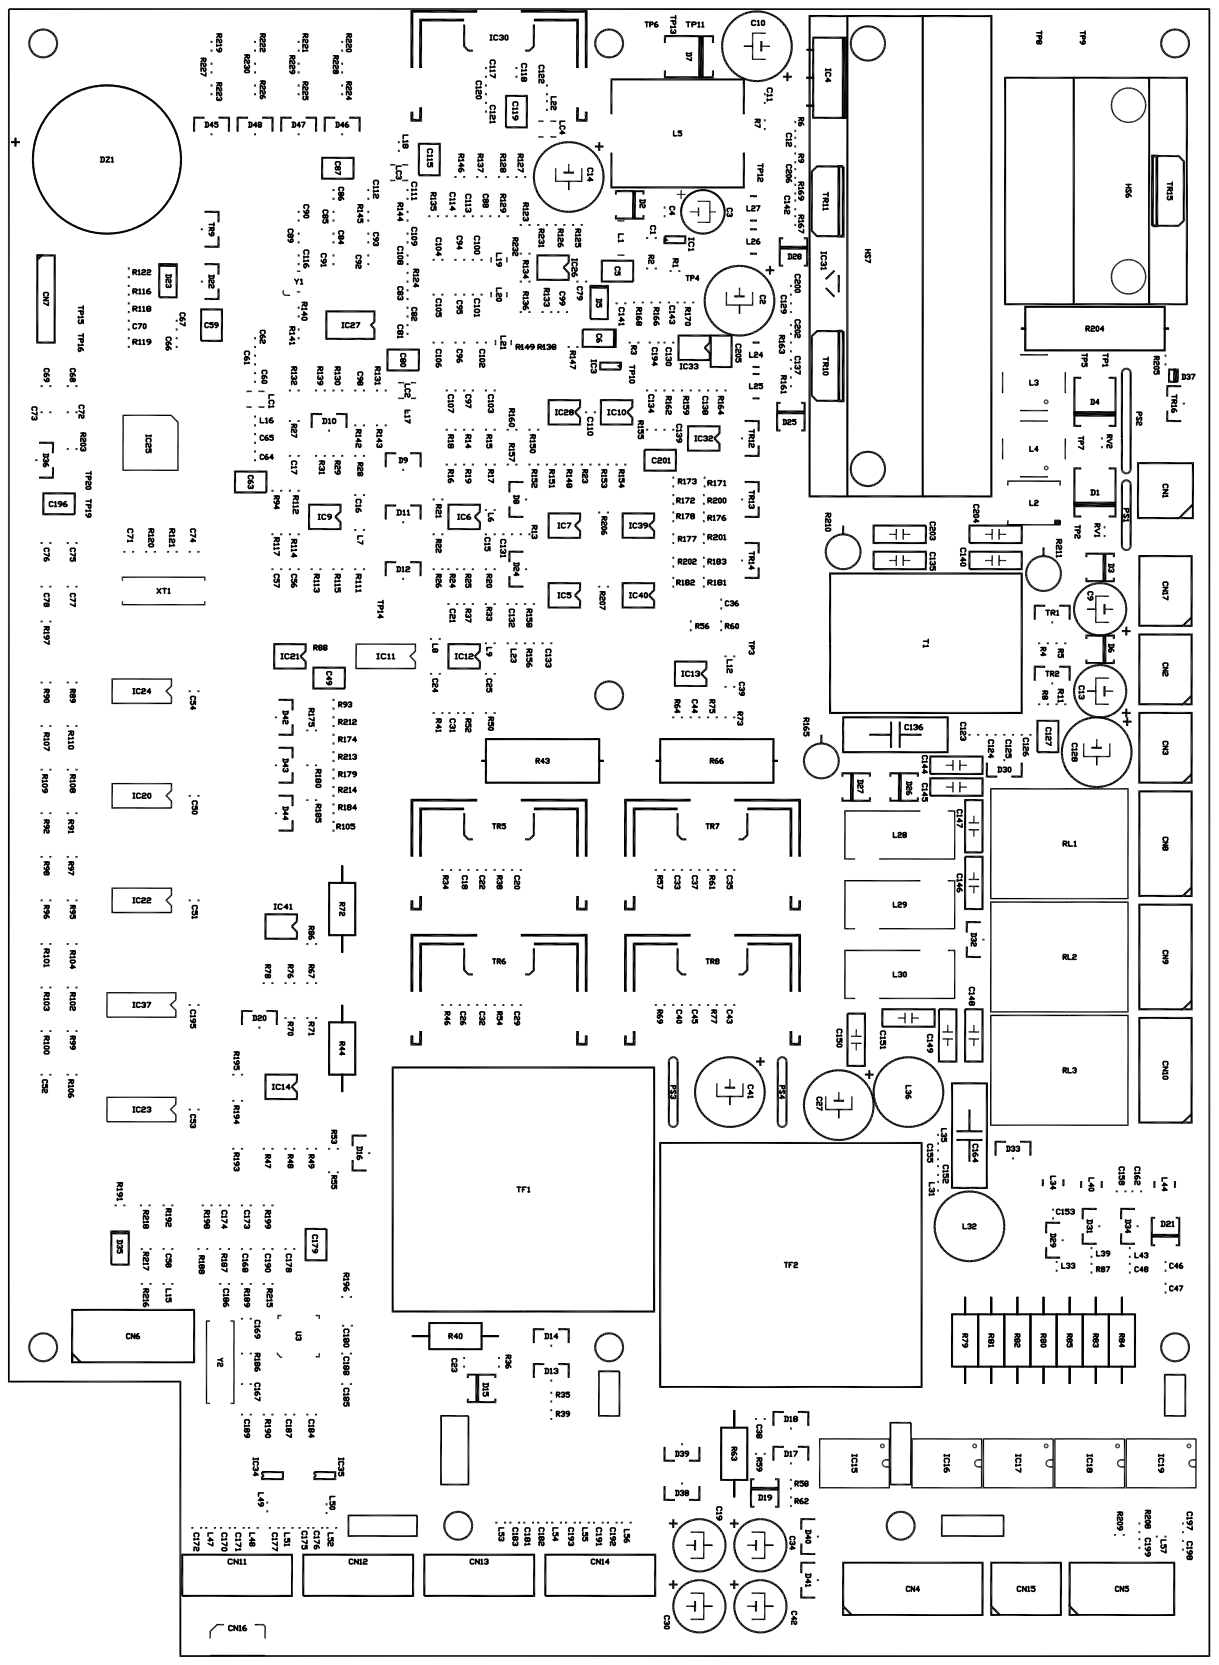
[picture p20: page 1]
