markopesevski/medyp_1/sims/20171218/current_limiter.asc

D1: zener; BZX84C15L
M1: pmos; SP8M51_P
Q1: pnp; BC327-25
R1: res; 3099
R2: res; 0.1
R3: res; 3
V1: voltage; 24
Named nets: 0
.tran 0 200u 0 1u uic
step param I list 1 2 3 4
step param R 470k 1MEG 10k
