markopesevski/medyp_1/sims/20171128/level_dacdds.asc

C88: cap; 100n
R98: res; 10k
R109: res; 10k
R123: res; 10k
R124: res; 5k6
R125: res; 820
R128: res; 470
R129: res; 1k
R231: res; 10k
U1: AD8047
U2: LTC2641-12
U3: LTC2641-12
V1: voltage; 12
V2: voltage; 1.2
V3: voltage; PWL(0 3.3 0.6u 3.3 +2n 0 +0.31u 0 +2n 3.3)
V4: voltage; PULSE(0 3.3 0 0.1n 0.1n 9.9n 20n)
V5: voltage; 3.3
V6: voltage; 3.3
V7: voltage; 5
V8: voltage; 1.5
V9: voltage; PWL(0 3.3 0.6u 3.3 +2n 0 +0.31u 0 +2n 3.3)
V10: voltage; PULSE(0 3.3 0 0.1n 0.1n 9.9n 20n)
V11: voltage; 3.3
V12: voltage; 3.3
V13: voltage; 5
V14: voltage; 1.5
Named nets: 0, FS_ADJ, POS, NEG, OUT, DACDDS, LEVEL
.tran 0 1 0 1m startup
;.dc VLEVEL 1 0 1m VDACDDS 1 0 1m
