markopesevski/medyp_1/main.h

/********************************************************************
 * FileName:		main.h											*
 * Dependencies:													*
 * Processor:		PIC32MX564F128H									*
 * Company:			Ingenia Projet 64 S.L.							*
 *																	*
 ********************************************************************
 * File Description:												*
 *																	*
 * 	- Librería que incluye todas las librerías.						*
 *																	*
 * Change History:			Versión 0.0								*
 *																	*
 * Name				Date            Changes							*
 * -----			-----			--------						*
 * J. Tejedor		16/11/15		Version inicial.				*
 *																	*
 ********************************************************************/
#include <plib.h>
#include <p32xxxx.h>
#include <stdlib.h>
#include <math.h>

#include "iomap.h"
#include "Control_TLC5620.h"
#include "Comunicacion.h"
#include "Delay.h"
#include "Tratamientos.h"
#include "usb.h"
#include "usb_function_hid.h"
#include "Control_TPIC.h"
#include "AD9834.h"
#include "Lectura_ADC.h"
#include "Control_Volumen.h"

typedef enum
{
	ARRAYS_SAVED = 0xDEADBEEF,
	ARRAYS_NOT_SAVED = 0xFFFFFFFF
} calibration_arrays_saved_t;

typedef enum calibration_values_t
{
	CALIBRATION_VALUE_UNDER = 0,
	CALIBRATION_VALUE_OK = 1,
	CALIBRATION_VALUE_OVER = 2
} calibration_values_t;

typedef enum
{
	CALIBRATION_READ_SERIAL = 0,
	CALIBRATION_SAVE_SERIAL = 1,
	CALIBRATION_READ_TEMP,
	CALIBRATION_READ_ALARM_TEMP,
	CALIBRATION_READ_GAL,
	CALIBRATION_SET_GAL,
	CALIBRATION_READ_STIM,
	CALIBRATION_SET_STIM,
	CALIBRATION_READ_RF,
	CALIBRATION_SET_RF,
	CALIBRATION_READ_BIAS,
	CALIBRATION_SET_BIAS,
	CALIBRATION_STARTING_RF,
	CALIBRATION_RF_RUNNING,
	CALIBRATION_START_SEARCH,
	CALIBRATION_SEARCHING_VALUE,
	CALIBRATION_CHECKING_VALUE,
	CALIBRATION_WAITING_ANRF_FALL_DOWN,
	CALIBRATION_FOUND_VALUE,
	CALIBRATION_VALUE_NOT_REACHABLE,
	CALIBRATION_SAVE_VALUES,
	CALIBRATION_ALL_VALUES_FOUND_FOR_SERIES,
	CALIBRATION_RF_READ_VOLTAGE,
	CALIBRATION_STOP_RF,
	CALIBRATION_WAITING_WARMUP,
	CALIBRATION_NO_STATE
} calibration_process_t;


typedef enum
{
	STANDBY = 2,
	READY = 0,
	ACTIVE = 1,
	GO_OUT_OF_TEST = 3
} machine_states_t;

typedef enum
{
	NO_TEST = 0,
	GALVANIC_TEST = 1,
	STIMULATION_TEST = 2,
	RF_TEST = 3,
	CALIBRA_RF = 4
} test_states_t;

typedef enum
{
	RF_value_0 = 0,
	RF_value_5 = 1,
	RF_value_10 = 2,
	RF_value_15 = 3,
	RF_value_20 = 4,
	RF_value_25 = 5,
	RF_value_30 = 6,
	RF_value_35 = 7,
	RF_value_40 = 8,
	RF_value_45 = 9,
	RF_value_50 = 10,
	RF_value_55 = 11,
	RF_value_60 = 12,
	RF_value_65 = 13,
	RF_value_70 = 14,
	RF_value_75 = 15,
	RF_value_80 = 16,
	RF_value_85 = 17,
	RF_value_90 = 18,
	RF_value_95 = 19,
	RF_value_100 = 20,
	RF_calibrate = 21,
	RF_max_values = 21
} rf_values_t;

typedef enum
{
	RF_freq_1mhz = 10,
	RF_freq_3mhz = 30,
	RF_freq_sweep = 0xBA,
	RF_freq_undef = 0x00 /* using 0 instead of 0xFF because it seems safer for the DDS signal generator */
} rf_frequencies_t;

#define DEBUGAR

// System command
#define SYS_FREQ (80000000L)
#define GetSystemClock()		(SYS_FREQ)
#define	GetPeripheralClock()	(SYS_FREQ/(1 << OSCCONbits.PBDIV))
#define GetInstructionClock()	(SYS_FREQ)

#ifndef DEBUG_MARKO
	// /* ORIGINAL */ #define T1_TICK					62500		// Tick general -> 	1tick = 50ms 	(a 80MHz).
	/* ORIGINAL */ #define T1_TICK					6250		// Tick general -> 	1tick = 5ms 	(a 80MHz).
#else // DEBUG_MARKO
	#define T1_TICK					1250		// Tick general -> 	1tick = 50ms 	(a 80MHz).
#endif // DEBUG_MARKO
#define T3_TICK					3125		// Tick galva -> 	1tick = 10ms 	(a 80MHz).
#define T4_TICK					62500		// Tick barrido ->	1tick = 50ms 	(a 80MHz).
#define T5_TICK					125			// Tick electrolif->1tick = 25us 	(a 80MHz).

// Valores predeterminados programa.
#define RX_DATA_BUFFER_ADDRESS
#define TX_DATA_BUFFER_ADDRESS

#define O_N					1
#define OFF					0
#define SI					1
#define NO					0

#define ON_POL				0
#define OFF_POL				1

#define IN					0
#define OUT					1

#define FACIAL				1 // Aplicador facial.
#define ESPE				2 // Aplicador específico.
#define CORPORAL			3 // Aplicador corporal.

#define PROBE1				1
#define PROBE2				2
#define PROBE3				3

#define TEMPERATURA_HS		30
#define TEMPERATURA_ALARMA	90 // A esta temperatura se para la RF.

#define SEGS_HS				60 // 1 minuto.
#define VOL_FAB				0 //1//5 TODO

#define DAC_GAL_FAB			56 //150	2.10.17 Se rebaja máxima corriente a 1.5mA
#define DAC_STIM_FAB		110
#define DAC_RF_FAB			114 //195//200
#define DAC_BIAS_FAB		82 // Con 82 hay 1.41V en DACBIAS (R153)



#define TIEMPO_REDUCIR		10 // Tiempo seguido sin detectar conducción para reducir RF. (0,2s x 10 = 2s)

// Órdenes
#define TRAMA_STATUS		2
#define TRAMA_VERSION		3
#define CONT_BUZZER			5
#define NIVEL_BUZZER		6
#define TRAMA_INICIA		8

#define TRAMA_FIRM			10
#define ERASE_BUF			12
#define TRANS_BUF			13

#define READ_TEMP			25
#define READ_ALARM_TEMP		26
#define SET_ALARM_TEMP		27

#define	READ_GAL			30
#define	SET_GAL				31
#define	READ_STIM			35
#define	SET_STIM			36
#define	READ_RF				40
#define	SET_RF				41
#define	READ_BIAS			43
#define	SET_BIAS			44
#define REC_CAL				48

#define READ_NSERIE			50
#define REC_NSERIE			51

#define ACTUALIZA			60
#define RST_FAB				88

// Valores predeterminados para TLV5620
#define REFDAC				0x100 // Selecciona salida A del dac.
#define DACGAL				0x300 // Selecciona salida B del dac.
#define SOUND				0x500 // Selecciona salida C del dac.
#define LEVEL				0x700 // Selecciona salida D del dac. 0x700 -Las salidas están x 2 (RNG = 1).

#define REFDACA				0x100 // Selecciona salida A del dac.
#define DACA				0x300 // Selecciona salida B del dac.
#define REFDACB				0x500 // Selecciona salida C del dac.
#define DACB				0x700 // Selecciona salida D del dac.

#define REFDACDDS			0x100 // Selecciona salida A del dac.
#define DACDDS				0x300 // Selecciona salida B del dac.
#define REFDACBIAS			0x500 // Selecciona salida C del dac.
#define DACBIAS				0x700 // Selecciona salida D del dac.

// Valores predeterminados NVM.
#define NVM_PROGRAM_PAGE 	0xBD01F000		// MIRAR BIEN DONDE ESCRIBO (en el .map)

/********************* Declaración de funciones *********************/
void Config_System (void);					// Configura oscilador del sistema.
void Config_Ports (void);					// Configura puertos.
void Init_Regs (void);						// Inicializa registros.
void Config_Timer1 (void);					// Configura el Timer1 (tick general).
void Config_Timer2 (void);					// Configura el Timer2.
void Config_Timer3 (void);					// Configura el Timer3.
void Config_Timer4 (void);					// Configura el Timer4.
void Config_Timer5 (void);					// Configura el Timer5.
void Stop_Timer1 (void);					// Para Timer1.
void Stop_Timer3 (void);					// Para Timer3.
void Stop_Timer4 (void);					// Para Timer4.
void Grabar_Flash (void);					// Memoriza variables.

/****************************** EOF *********************************/
