markopesevski/medyp_1/Control_Volumen.h

/********************************************************************
 * FileName:		Control_Volumen.h								*
 * Dependencies:													*
 * Processor:		PIC32MX564F128H									*
 * Company:			Ingenia Projet 64 S.L.							*
 *																	*
 ********************************************************************
 * File Description:												*
 *																	*
 * 	- Librería para Control_Volumen.c.								*
 *																	*
 * Change History:			Versión 0.0								*
 *																	*
 * Name				Date            Changes							*
 * -----			-----			--------						*
 * J. Tejedor		09/03/17		Versión inicial.				*
 *																	*
 ********************************************************************/

/********************* Declaración de funciones *********************/
 void Control_Volumen(unsigned char volum);

/****************************** EOF *********************************/
