markopesevski/medyp_1/boot/Control_TPIC.h

/******************************************************************** 
 * FileName:		Control_TPIC.h									*
 * Dependencies:													*
 * Processor:		PIC32MX564F128H									*
 * Company:			Ingenia Projet 64 S.L.							*
 *																	*	
 ********************************************************************
 * File Description:												*
 *																	*	
 *	- Librería para Control_TPIC.c.									*
 *						 											*
 * Change History:													*
 *																	*
 * Name				Date            Changes							*	
 * -----			-----			--------						*
 * J. Tejedor		11/11/15		Version inicial.				*
 *																	*
 ********************************************************************/
/*  Declaración de funciones  */
void Control_TPIC (void);

/**************************** EOF ***********************************/
