markopesevski/medyp_1/boot/Actualizacion.c

/********************************************************************
 * FileName:		Actualizacion.c									*
 * Dependencies:													*
 * Processor:		PIC32MX564F128H									*
 * Company:			Ingenia											*
 *																	*
 ********************************************************************
 * File Description:												*
 *																	*
 * 	- Gestiona la actualización a través de la INTAB.				*
 *																	*
 * Change History:			Versión 0.0								*
 *																	*
 * Name				Date            Changes							*
 * -----			-----			--------						*
 * J. Tejedor		18/10/16		Versión inicial.				*
 *																	*
 ********************************************************************/
#include "main.h"

extern unsigned char Saved_OK;
extern unsigned int Suma_Bytes;
extern unsigned char Error_While;

typedef struct 
{
	UINT8 RecDataLen;
	DWORD_VAL Address;
	UINT8 RecType;
	UINT8* Data;
	UINT8 CheckSum;	
	DWORD_VAL ExtSegAddress;
	DWORD_VAL ExtLinAddress;
}T_HEX_RECORD;

unsigned int USER_APP_RESET_ADDRESS = (APP_FLASH_BASE_ADDRESS + 0x1000);

/********************************************************************
 * Function:	ConvertAsciiToHex(asciiRec,hexRec)					*
 * Definition:	Converts ASCII to Hex.								*
 ********************************************************************/
void ConvertAsciiToHex(UINT8* asciiRec, UINT8* hexRec)
{
	UINT8 i = 0;
	UINT8 k = 0;
	UINT8 hex;
	
	while((asciiRec[i] >= 0x30) && (asciiRec[i] <= 0x66))
	{
		// Check if the ascci values are in alpha numeric range.
		
		if(asciiRec[i] < 0x3A)
		{
			// Numerical reperesentation in ASCII found.
			hex = asciiRec[i] & 0x0F;
		}
		else
		{
			// Alphabetical value.
			hex = 0x09 + (asciiRec[i] & 0x0F);						
		}
	
		// Following logic converts 2 bytes of ASCII to 1 byte of hex.
		k = i%2;
		
		if(k)
		{
			hexRec[i/2] |= hex;
			
		}
		else
		{
			hexRec[i/2] = (hex << 4) & 0xF0;
		}	
		i++;		
	}
}

/********************************************************************
 * Function:	WriteHexRecord2Flash(HexRecord)						*
 * Definition:	Writes Hex Records to Flash.						*
 ********************************************************************/
void WriteHexRecord2Flash(UINT8* HexRecord)
{
	static T_HEX_RECORD HexRecordSt;
	UINT8 Checksum = 0;
	UINT8 i;
	UINT WrData;
	UINT RdData;
	void* ProgAddress;
	UINT result;
		
	HexRecordSt.RecDataLen = HexRecord[0];
	HexRecordSt.RecType = HexRecord[3];	
	HexRecordSt.Data = &HexRecord[4];	
	
	// Hex Record checksum check.
	for(i = 0; i < HexRecordSt.RecDataLen + 5; i++)
	{
		Checksum += HexRecord[i];
	}	
	
    if(Checksum != 0)
    {
	    //Error. Hex record Checksum mismatch.
	    Error_While = 1;	//while(1);
	} 
	else
	{
		// Hex record checksum OK.
		switch(HexRecordSt.RecType)
		{
			case DATA_RECORD:  //Record Type 00, data record.
				HexRecordSt.Address.byte.MB = 0;
					HexRecordSt.Address.byte.UB = 0;
					HexRecordSt.Address.byte.HB = HexRecord[1];
					HexRecordSt.Address.byte.LB = HexRecord[2];
					
					// Derive the address.
					HexRecordSt.Address.Val = HexRecordSt.Address.Val + HexRecordSt.ExtLinAddress.Val + HexRecordSt.ExtSegAddress.Val;
					
					while(HexRecordSt.RecDataLen) // Loop till all bytes are done.
					{
											
						// Convert the Physical address to Virtual address. 
						ProgAddress = (void *)PA_TO_KVA0(HexRecordSt.Address.Val);
		
						// Make sure we are not writing boot area and device configuration bits.
						if(((ProgAddress >= (void *)APP_FLASH_BASE_ADDRESS) && (ProgAddress <= (void *)APP_FLASH_END_ADDRESS))
						   && ((ProgAddress < (void*)DEV_CONFIG_REG_BASE_ADDRESS) || (ProgAddress > (void*)DEV_CONFIG_REG_END_ADDRESS)))
						{
							if(HexRecordSt.RecDataLen < 4)
							{
								// Sometimes record data length will not be in multiples of 4. Appending 0xFF will make sure that..
								// we don't write junk data in such cases.
								WrData = 0xFFFFFFFF;
								memcpy(&WrData, HexRecordSt.Data, HexRecordSt.RecDataLen);	
							}
							else
							{	
								memcpy(&WrData, HexRecordSt.Data, 4);
							}		
							// Write the data into flash.
							result = NVMWriteWord(ProgAddress, WrData);
							Suma_Bytes++;
						
							// Assert on error. This must be caught during debug phase.		
							if(result != 0)
							{
    							Error_While = 1;	//while(1);
    						}									
						}	
						
						// Increment the address.
						HexRecordSt.Address.Val += 4;
						// Increment the data pointer.
						HexRecordSt.Data += 4;
						// Decrement data len.
						if(HexRecordSt.RecDataLen > 3)
						{
							HexRecordSt.RecDataLen -= 4;
						}	
						else
						{
							HexRecordSt.RecDataLen = 0;
						}	
					}
					break;
			
			case EXT_SEG_ADRS_RECORD:  // Record Type 02, defines 4th to 19th bits of the data address.
			    HexRecordSt.ExtSegAddress.byte.MB = 0;
				HexRecordSt.ExtSegAddress.byte.UB = HexRecordSt.Data[0];
				HexRecordSt.ExtSegAddress.byte.HB = HexRecordSt.Data[1];
				HexRecordSt.ExtSegAddress.byte.LB = 0;
				// Reset linear address.
				HexRecordSt.ExtLinAddress.Val = 0;
				break;
				
			case EXT_LIN_ADRS_RECORD:   // Record Type 04, defines 16th to 31st bits of the data address. 
				HexRecordSt.ExtLinAddress.byte.MB = HexRecordSt.Data[0];
				HexRecordSt.ExtLinAddress.byte.UB = HexRecordSt.Data[1];
				HexRecordSt.ExtLinAddress.byte.HB = 0;
				HexRecordSt.ExtLinAddress.byte.LB = 0;
				// Reset segment address.
				HexRecordSt.ExtSegAddress.Val = 0;
				break;
				
			case END_OF_FILE_RECORD:  //Record Type 01, defines the end of file record.
				HexRecordSt.ExtSegAddress.Val = 0;
				HexRecordSt.ExtLinAddress.Val = 0;

				if (Error_While == 0) Saved_OK = 1;				
				break;
				
			default: 
				HexRecordSt.ExtSegAddress.Val = 0;
				HexRecordSt.ExtLinAddress.Val = 0;
				break;
		}		
	}
}

/********************************************************************
 * Function:	EraseFlash()										*
 * Definition:	Borra Flash.										*
 ********************************************************************/
void EraseFlash(void)
{
	void * pFlash;
    UINT result;
    INT i;

	pFlash = (void*)APP_FLASH_BASE_ADDRESS;
	for(i=0;i<((APP_FLASH_END_ADDRESS - APP_FLASH_BASE_ADDRESS + 1)/FLASH_PAGE_SIZE);i++)
	{
		result = NVMErasePage(pFlash + (i*FLASH_PAGE_SIZE));
	   	// Assert on NV error. This must be caught during debug phase.

       	if(result != 0)
       	{
	       	// We have a problem. This must be caught during the debug phase.
			Error_While = 1;	//while(1);
        }
    }      	     
}

/********************************************************************
 * Function:	JumpToApp()											*
 * Definition:	Jumps to application.								*
 ********************************************************************/
void JumpToApp(void)
{
	USER_APP_RESET_ADDRESS = (APP_FLASH_BASE_ADDRESS + 0x1000);
	
	void (*fptr)(void);
	fptr = (void (*)(void))USER_APP_RESET_ADDRESS;
	fptr();
}

/****************************** EOF *********************************/
