markopesevski/medyp_1/boot/NVMem.h

// Copyright (c) 2002-2010,  Microchip Technology Inc.
//
// Microchip licenses this software to you solely for use with Microchip
// products.  The software is owned by Microchip and its licensors, and
// is protected under applicable copyright laws.  All rights reserved.
//
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
// To the fullest extent allowed by law, Microchip and its licensors
// liability shall not exceed the amount of fees, if any, that you
// have paid directly to Microchip to use this software.
//
// MICROCHIP PROVIDES THIS SOFTWARE CONDITIONALLY UPON YOUR ACCEPTANCE
// OF THESE TERMS.
#ifndef __NVMEM_H__
#define __NVMEM_H__

#define PAGE_SIZE               1024        // # of 32-bit Instructions per Page
#define BYTE_PAGE_SIZE          (4 * PAGE_SIZE) // Page size in Bytes
#define ROW_SIZE                128         // # of 32-bit Instructions per Row
#define BYTE_ROW_SIZE           (4 * ROW_SIZE) // # Row size in Bytes
#define NUM_ROWS_PAGE           8              //Number of Rows per Page 

#define NVMOP_WORD_PGM          0x4001      // Word program operation
#define NVMOP_PAGE_ERASE        0x4004      // Page erase operation
#define NVMOP_ROW_PGM           0x4003      // Row program operation
#define NVMOP_NOP               0x4000      // NOP operation

#ifdef __cplusplus
extern "C" {
#endif
extern unsigned int NVMemWriteWord(void* address, unsigned int data);
extern unsigned int NVMemErasePage(void* address);
extern unsigned int NVMemWriteRow(void* address, void* data);
extern unsigned int NVMemClearError(void);
#ifdef __cplusplus
}
#endif


#endif
