markopesevski/medyp_1/(commit log)

2017-12-12 Lots of changes made to be able to develop calibration. Still untested because of hardware problems with USB hub
    [20171207_CONTROL_VERIFICACION_MESOTREAT_RF_3.xlsx, 20171207_full control verificacio mesotreat rf_protos_3.xlsx, 20171212 - taules definitives vrms.xlsx, Schematic1.sch, mostres_an_rf.xlsx, mostres_an_rf_vrms_placa_9_preserie.xlsx, mostres_vrms_vs_level.xlsx]
2017-12-15 Some WIP made on the auto-calibration. 1 MHz almost working, 3 MHz has problems on hardware with 10 pre-series PCBs. Pending on receiving prototype PCB from Rös's for checking changes
    [20171212 - taules definitives vrms.xlsx]
2017-12-20 Added function for reading 24VRF. May be useful to read periodically when RF is on to check we are not drifting too much
    [Lectura_ADC.c]
2017-12-20 Added function for reading Vrms at ANRF at 3 MHz. Done a couple of samplings and seems very linear
    [20171213 - prova fallida ajust 3mhz.xlsx, 20171219 - mostres_3mhz.xlsx]
2017-12-20 [WARNING] Changes to the debug main function to be able to sample the voltages for 3 MHz. WARNING: Timer1 tick is accelerated to be 1 ms
2017-12-20 Synchro: commit before starting to deal with 3 MHz auto-calibration
2017-12-21 More minor code cleanup and restyling and also IMPORTANT: changed tick frequencies, and starting to implement the RF reading while in loop. Next the control and calibration process will come
2017-12-21 Added moving average reading to the ANRF voltage, warmup process to the calibration, and other minor changes
2017-12-21 Added control process to the main loop to prevent some drift in the output
    [Tratamientos.h, main.c]
2017-12-21 Adding some files I had leftover (some documents generated), schematics and bootloader
    [20171220_valors_taules_defecte_v1.xlsx]
2017-12-22 Added saving of parameters to non-volatile memory. Saving them as registers of 32bits, so saving/reading 4 bytes at a time (shifting accordingly). Also deleting some linker scripts that are not used.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
    [20171221 - parametres per defecte DACDDS i LEVEL.xlsx]
2017-12-22 Changed couple linker settings to original values just to check sanity
2017-12-22 Removed flag that forces not to reduce output power when we do not detect galvanic current. This flag was useful for debugging but is needed in normal operation of the device
2017-12-22 Added a couple of folders to .gitignore
2017-12-22 Removed unused variable to avoid having warnings on compiling
    [main.c]
2017-12-22 Changes to build options to be able to update board from boot
2017-12-22 Changing Timer1's timebase to 5ms to be able to control output RF faster. Changing waiting ticks accordingly. Also adding a little bit of exception handling code due to trying to debug the NVM writin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
    [20171222_comparativa_nvm.xlsx]
2017-12-22 Changing condition for conditional because did not perform software updates correctly
    [main.c]
2018-01-02 Unnecessary change to the bootloader's code. The problem seems to be in the tablet side of the system. Loading a code coming just from the bootloader, and then power cycling the system seems to work 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
    [main.c]
2018-01-02 Corrected error in control loop for output voltages (oscillation when changing from maximum when over to under voltage). Now change should be equally smooth
    [Tratamientos.c, main.c]
2018-01-03 Added averaging for calculating the sweep values, and corrected warmup time
    [Tratamientos.c]
2018-01-03 Leaving more margin for drift correction
    [Tratamientos.h]
2018-01-04 Eliminating some unnecessary sch files, and a couple changes to gitignore
2018-01-15 Added new docs generated with new table values received from client, also changed autocalibration process explanation to simplify a lot
    [20180115_grafics_adc.xlsx, 20180115_valors_nous.xlsx]
2018-01-15 Separating the two tables that were together (facial and specific handles). Adding new ANRF tables for specific treatment, and also changing default values. Also adding the 'new' treatment to the aut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
2018-01-15 Added linker script to project, and changed version. THIS VERSION IS TOTALLY INCOMPATIBLE WITH 1.1.0. When coming from 1.1.0 autocalibration should be performed and new values saved to NVM
    [Tratamientos.c]
2018-01-16 Added calculation for time to wait for warmup dependent on the tick of Timer1. Also changing the speed at which calibration actions are taken in order to speed up autocalibration. Resolved the issue 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
    [Tratamientos.c, Tratamientos.h, main.c, main.h]
2018-01-16 Adding OVER control to warmup stage to prevent going too high during too much time because IRF640s blow up
    [Tratamientos.c, Tratamientos.h]
2018-01-16 Correcting the way I start RF when starting RF, because otherwise when I started a sweep the last value was kept in dacdds_value and level_value and the RF level jumped. Another change done is that t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
    [Tratamientos.c, main.c]
2018-01-16 Since the control loop now works 5 times faster, I have to not return dacdds correction to 0 when changing level because there were very visible steps on the output, and these should be avoided
    [main.c]
2018-01-16 Docs generated
    [20180116_comparativa_autocalibracio_lent_vs_rapid.xlsx]
2018-02-06 Strange behaviour: when letting go treatment from skin, sometimes device goes haywire and burns transistors. Control loop may (or may not) be suspicious
2018-02-09 Changed the way I call the function that tells if voltage is correct. It now returns the voltage supposed to be compared with. Also added some debug output on UART3. Big changes: - When in sweep, vol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
    Also adding some documentation on the reasoning behind all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
    [Tratamientos.c, Tratamientos.h, debug_variables.pde, main.c]
